controlpaths/tramuntana/hw/tramuntana_lite_r1a/img/tramuntana_asturcon_back.jpeg

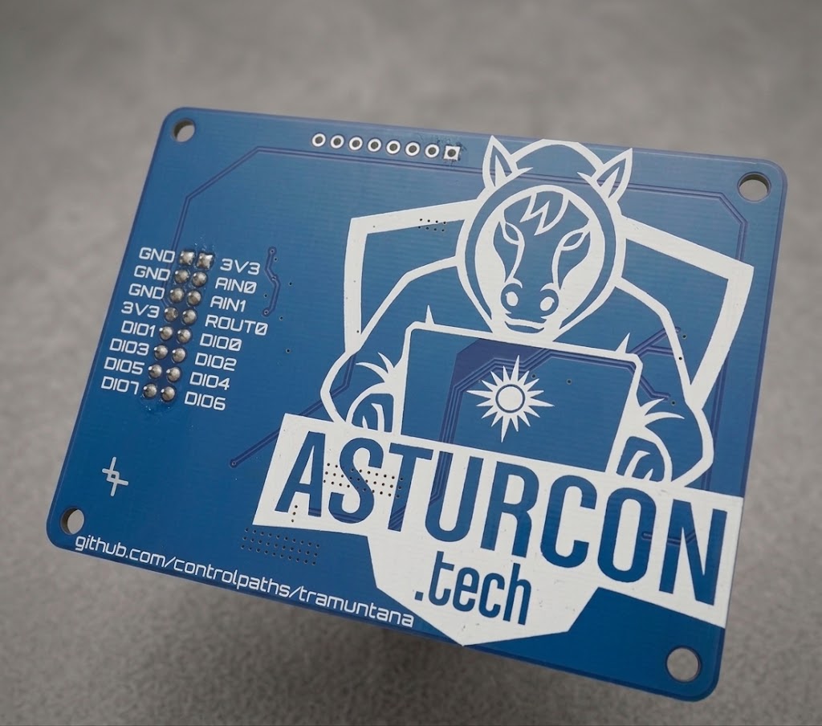
hw/tramuntana_lite_r1a/img/tramuntana_asturcon_back.jpeg
