controlpaths/tramuntana/hw/tramuntana_lite_r1a/case/tramuntana_lite_case_assembly.step

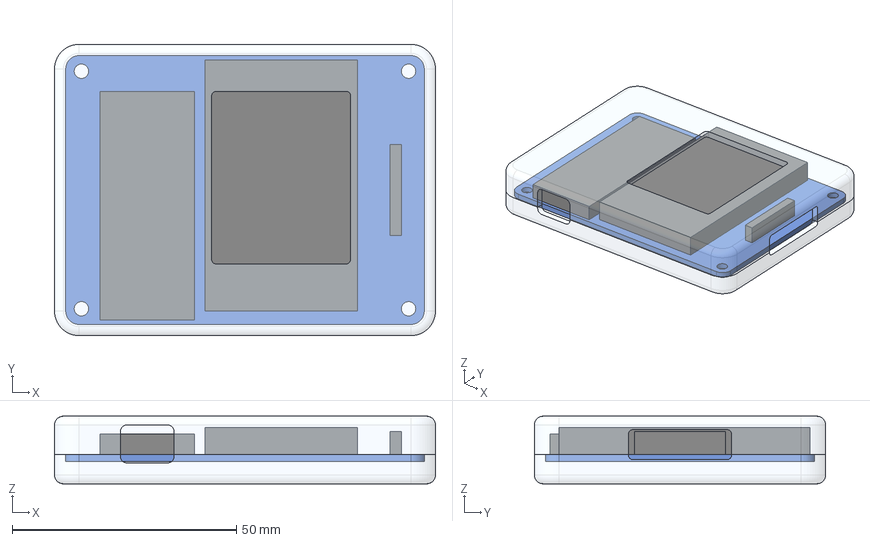
[picture p5: CAD file, 2026-10-11]
hw/tramuntana_lite_r1a/case/tramuntana_lite_case_assembly.step
85.0 x 65.0 x 15.1 mm
base
lid
pcb
display
pico
header
