controlpaths/tramuntana/hw/tramuntana_lite_r1a/case/tramuntana_lite_case_lid.step

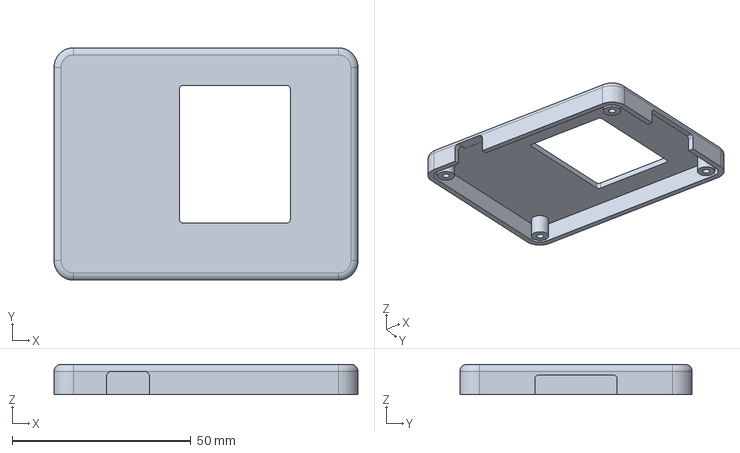
[picture p6: CAD file, 2026-10-11]
hw/tramuntana_lite_r1a/case/tramuntana_lite_case_lid.step
85.0 x 65.0 x 8.50 mm
