controlpaths/tramuntana/hw/tramuntana_lite_r1a/case/tramuntana_lite_case_lid_opaque_nodisplay.step

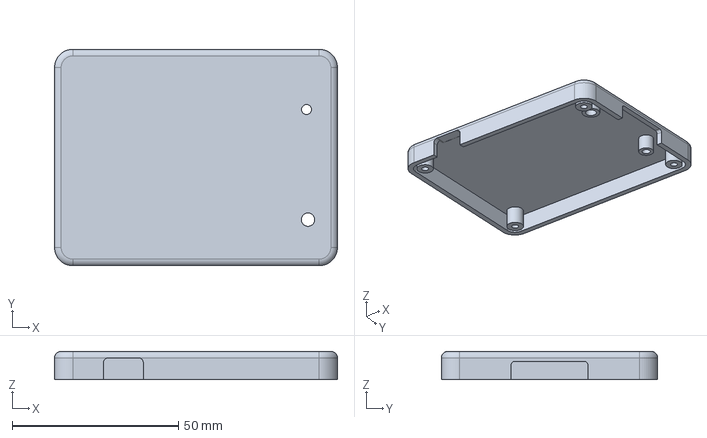
[picture p7: CAD file, 2026-10-11]
hw/tramuntana_lite_r1a/case/tramuntana_lite_case_lid_opaque_nodisplay.step
85.0 x 65.0 x 8.50 mm
