controlpaths/tramuntana/hw/tramuntana_lite_r1a/case/tramuntana_lite_case_base.step

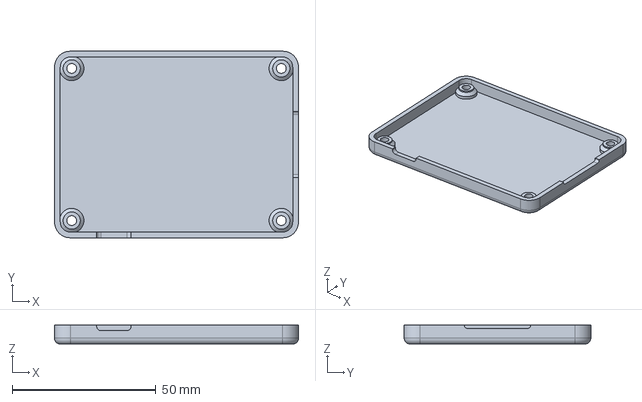
[picture p9: CAD file, 2026-10-11]
hw/tramuntana_lite_r1a/case/tramuntana_lite_case_base.step
85.0 x 65.0 x 6.60 mm
