controlpaths/tramuntana/(list of files, cad)

Other CAD files:
hw/tramuntana_lite_r1a/case/tramuntana_lite_case_base.stl
hw/tramuntana_lite_r1a/case/tramuntana_lite_case_lid.stl
hw/tramuntana_lite_r1a/case/tramuntana_lite_case_lid_nodisplay.stl
hw/tramuntana_lite_r1a/case/tramuntana_lite_case_lid_opaque.stl
hw/tramuntana_lite_r1a/case/tramuntana_lite_case_lid_opaque_nodisplay.stl
