controlpaths/tramuntana/hw/tramuntana_proto_r1a/kicad/tramuntana_proto_r1a.kicad_pcb

## KiCad design hw/tramuntana_proto_r1a/kicad/tramuntana_proto_r1a.kicad_pcb (2026-10-11)

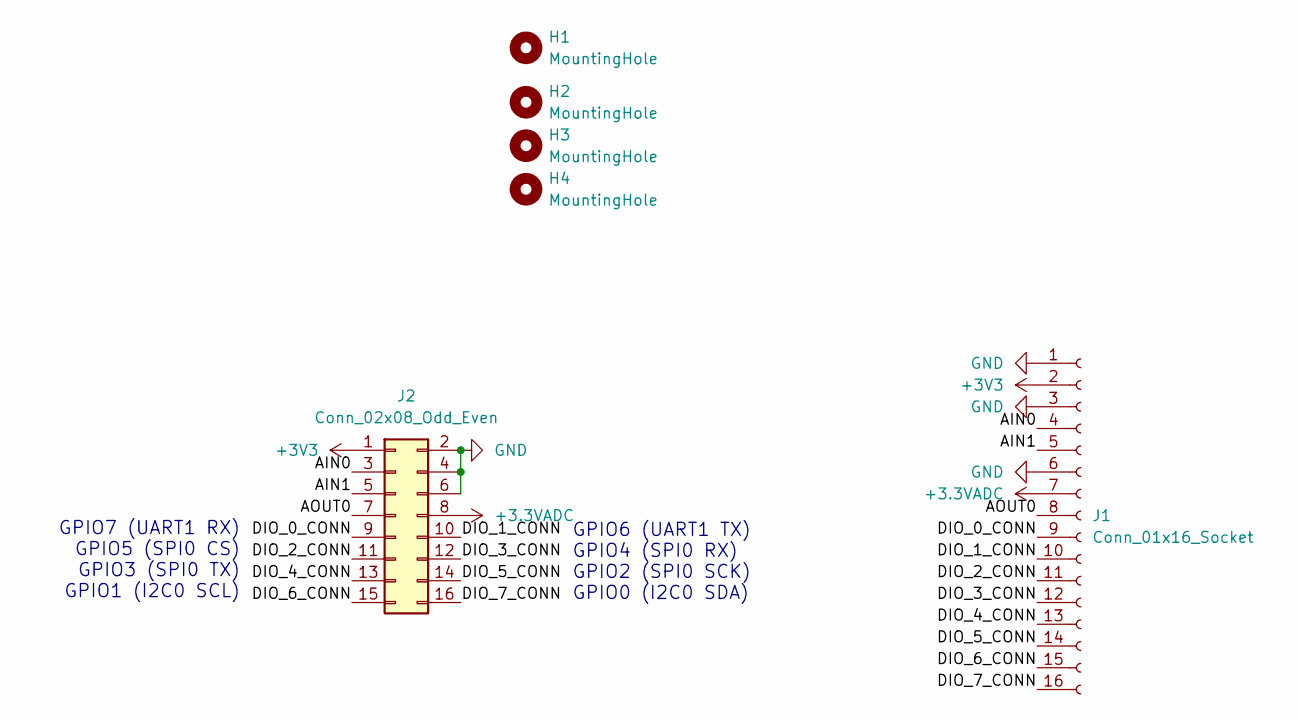
[picture p11: schematic tramuntana_proto_r1a.kicad_sch]

Parts:
H1, H2, H3, H4: MountingHole; MountingHole_3.2mm_M3
J1: Conn_01x16_Socket; PinSocket_1x16_P2.54mm_Vertical
J2: Conn_02x08_Odd_Even; PinSocket_2x08_P2.54mm_Horizontal

Connections:
+3.3VADC: J1.7, J2.8
+3V3: J1.2, J2.1
/AIN0: J1.4, J2.3
/AIN1: J1.5, J2.5
/AOUT0: J1.8, J2.7
/DIO_0_CONN: J1.9, J2.9
/DIO_1_CONN: J1.10, J2.10
/DIO_2_CONN: J1.11, J2.11
/DIO_3_CONN: J1.12, J2.12
/DIO_4_CONN: J1.13, J2.13
/DIO_5_CONN: J1.14, J2.14
/DIO_6_CONN: J1.15, J2.15
/DIO_7_CONN: J1.16, J2.16
GND: J1.1, J1.3, J1.6, J2.2, J2.4, J2.6

Notes on the sheet:
GPIO7 (UART1 RX) GPIO5 (SPI0 CS) GPIO3 (SPI0 TX) GPIO1 (I2C0 SCL)
GPIO6 (UART1 TX) GPIO4 (SPI0 RX) GPIO2 (SPI0 SCK) GPIO0 (I2C0 SDA)

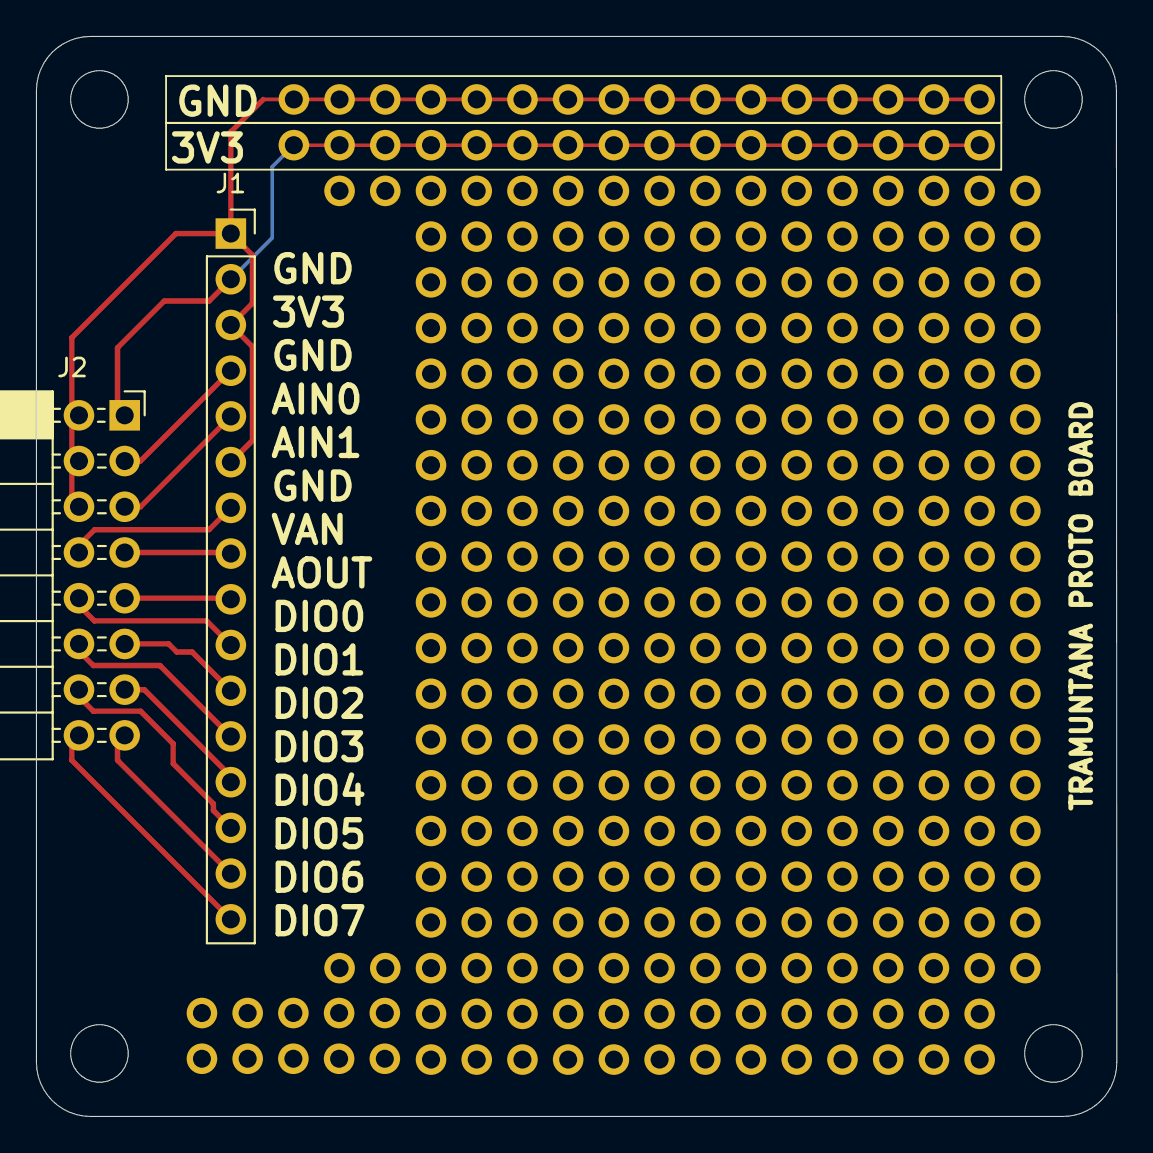
[picture p12: board tramuntana_proto_r1a.kicad_pcb from above]

Board: 2 copper layers, 60.0 x 60.0 mm, 6 parts (0 on the bottom side), 14 nets.
