controlpaths/tramuntana/hw/tramuntana_lite_r1a/kicad/tramuntana_lite_r1a.kicad_pcb

## KiCad design hw/tramuntana_lite_r1a/kicad/tramuntana_lite_r1a.kicad_pcb (2026-10-11)

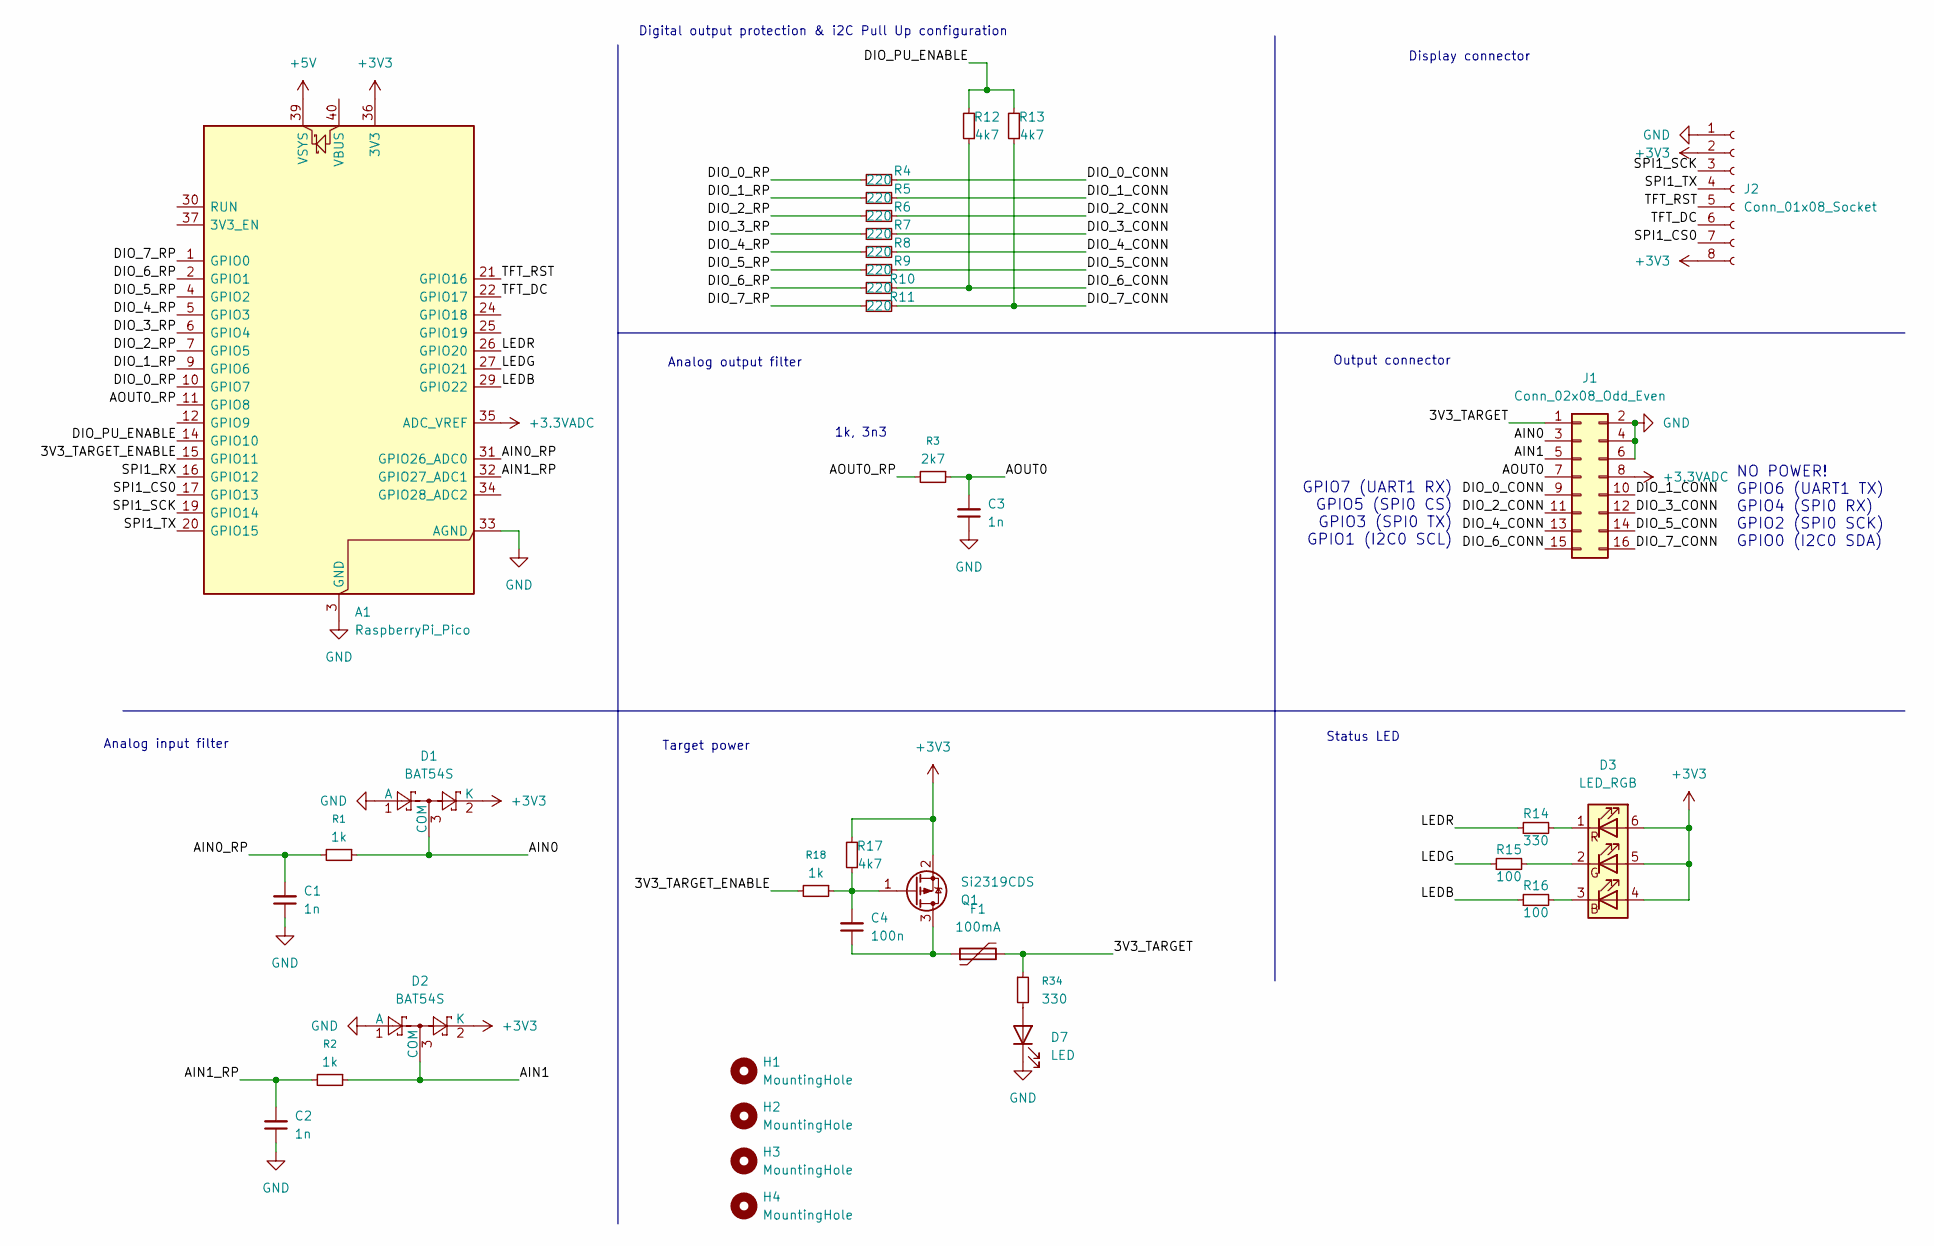
[picture p13: schematic tramuntana_lite_r1a.kicad_sch]

Parts:
A1: RaspberryPi_Pico; RaspberryPi_Pico_Common_Unspecified
C1, C2, C3: 1n; C_0603_1608Metric_Pad1.08x0.95mm_HandSolder
C4: 100n; C_0603_1608Metric_Pad1.08x0.95mm_HandSolder
D1, D2: BAT54S; SOT-23
D3: LED_RGB; LED_RGB_5050-6
D7: LED; LED_0603_1608Metric
F1: 100mA; Fuse_0805_2012Metric
H1, H2, H3, H4: MountingHole; MountingHole_3.2mm_M3
J1: Conn_02x08_Odd_Even; PinHeader_2x08_P2.54mm_Horizontal
J2: Conn_01x08_Socket; PinHeader_1x08_P2.54mm_Vertical
Q1: Si2319CDS; SOT-23
R1, R2: 1k; R_0603_1608Metric_Pad0.98x0.95mm_HandSolder
R3: 2k7; R_0603_1608Metric_Pad0.98x0.95mm_HandSolder
R4, R5, R6, R7, R8, R9, R10, R11: 220; R_0603_1608Metric
R12, R13, R17: 4k7; R_0603_1608Metric
R14: 330; R_0603_1608Metric
R15, R16: 100; R_0603_1608Metric
R18: 1k; R_0603_1608Metric
R34: 330; R_0603_1608Metric_Pad0.98x0.95mm_HandSolder

Connections:
+3.3VADC: A1.35 (ADC_VREF), J1.8
+3V3: A1.36 (3V3), D1.2 (K), D2.2 (K), D3.4 (BA), D3.5 (GA), D3.6 (RA), J2.2, J2.8, Q1.2 (S), R17.2
+5V: A1.39 (VSYS)
/3V3_TARGET: F1.2, J1.1, R34.1
/3V3_TARGET_ENABLE: A1.15 (GPIO11), R18.2
/AIN0: D1.3 (COM), J1.3, R1.1
/AIN0_RP: A1.31 (GPIO26_ADC0), C1.2, R1.2
/AIN1: D2.3 (COM), J1.5, R2.1
/AIN1_RP: A1.32 (GPIO27_ADC1), C2.2, R2.2
/AOUT0: C3.2, J1.7, R3.1
/AOUT0_RP: A1.11 (GPIO8), R3.2
/DIO_0_CONN: J1.9, R4.2
/DIO_0_RP: A1.10 (GPIO7), R4.1
/DIO_1_CONN: J1.10, R5.2
/DIO_1_RP: A1.9 (GPIO6), R5.1
/DIO_2_CONN: J1.11, R6.2
/DIO_2_RP: A1.7 (GPIO5), R6.1
/DIO_3_CONN: J1.12, R7.2
/DIO_3_RP: A1.6 (GPIO4), R7.1
/DIO_4_CONN: J1.13, R8.2
/DIO_4_RP: A1.5 (GPIO3), R8.1
/DIO_5_CONN: J1.14, R9.2
/DIO_5_RP: A1.4 (GPIO2), R9.1
/DIO_6_CONN: J1.15, R10.2, R12.1
/DIO_6_RP: A1.2 (GPIO1), R10.1
/DIO_7_CONN: J1.16, R11.2, R13.1
/DIO_7_RP: A1.1 (GPIO0), R11.1
/DIO_PU_ENABLE: A1.14 (GPIO10), R12.2, R13.2
/LEDB: A1.29 (GPIO22), R16.1
/LEDG: A1.27 (GPIO21), R15.1
/LEDR: A1.26 (GPIO20), R14.1
/SPI1_CS0: A1.17 (GPIO13), J2.7
/SPI1_RX: A1.16 (GPIO12)
/SPI1_SCK: A1.19 (GPIO14), J2.3
/SPI1_TX: A1.20 (GPIO15), J2.4
/TFT_DC: A1.22 (GPIO17), J2.6
/TFT_RST: A1.21 (GPIO16), J2.5
GND: A1.3 (GND), A1.8 (GND), A1.13 (GND), A1.18 (GND), A1.23 (GND), A1.28 (GND), A1.33 (AGND), A1.38 (GND), C1.1, C2.1, C3.1, D1.1 (A), D2.1 (A), D7.1 (K), J1.2, J1.4, J1.6, J2.1
unnamed: D3.3 (BK), R16.2
unnamed: D3.2 (GK), R15.2
unnamed: D3.1 (RK), R14.2
unnamed: D7.2 (A), R34.2
unnamed: C4.1, F1.1, Q1.3 (D)
unnamed: C4.2, Q1.1 (G), R17.1, R18.1

Notes on the sheet:
Target power
Output connector
Analog output filter
Analog input filter
NO POWER! GPIO6 (UART1 TX) GPIO4 (SPI0 RX) GPIO2 (SPI0 SCK) GPIO0 (I2C0 SDA)
Display connector
Status LED
Digital output protection & i2C Pull Up configuration
1k, 3n3
GPIO7 (UART1 RX) GPIO5 (SPI0 CS) GPIO3 (SPI0 TX) GPIO1 (I2C0 SCL)

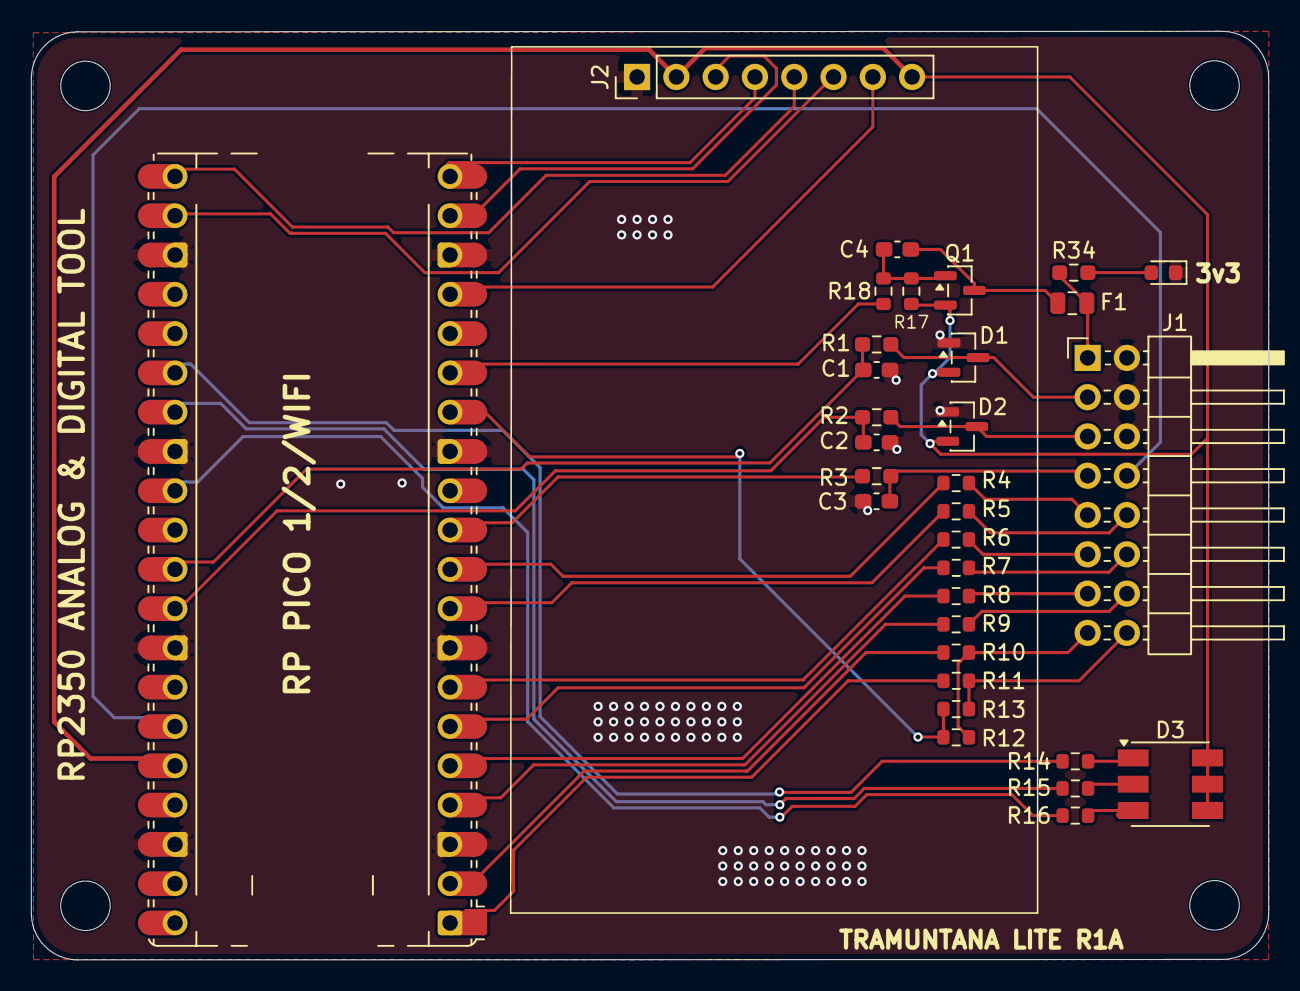
[picture p14: board tramuntana_lite_r1a.kicad_pcb from above]

Board: 2 copper layers, 80.0 x 60.0 mm, 36 parts (0 on the bottom side), 42 nets.
