controlpaths/tramuntana/host/python/tramuntana/mcp_server.py

"""MCP server exposing the Tramuntana hardware hacking tool to AI agents.

Lets an MCP client (Claude Code, Claude Desktop, Copilot...) drive a
Tramuntana board: target power, SPI/I2C master and sniffers, oscilloscope,
waveform generator, logic analyzer, DIO, ADC and the USB-UART bridge.

It is a thin layer over the rest of this package, so the agent does exactly
what the CLI, the webapp and user scripts do - nothing here talks the
binary protocol by itself.

Needs the [mcp] extra (pip install "tramuntana[mcp]"). Agents launch it over
stdio as `python -m tramuntana.mcp_server` (or the `tramuntana-mcp` script);
`tramuntana ai install <agent>` registers it.
"""

import functools
import io
import os
import threading
import time
from collections import deque
from typing import Annotated, Dict, List, Literal, Optional, Tuple

import serial

try:
    from pydantic import Field
    from mcp.server.fastmcp import FastMCP, Image
except ImportError as e:
    raise SystemExit(f"tramuntana MCP server: {e.name} is missing; install the extra with "
                     "pip install \"tramuntana[mcp]\"") from None

from tramuntana import (EmuTransfer, LinkError, ProtoError, Sequence, Timeline, Tramuntana, UartTap,
                        decode, find_ports)
from tramuntana import proto as P
from tramuntana.device import I2cMessage, SpiMessage, decode_event

INSTRUCTIONS = """\
Tramuntana is an RP2350-based bench tool for embedded targets, wired to the
target through a 16-pin header (J1):

  J1.1  3V3   switched 3.3 V rail for the target (tool: power)
  J1.3  AIN0  scope ch0 / adc 0      J1.5  AIN1  scope ch1 / adc 1   (0..3.3 V)
  J1.7  AOUT0 waveform generator (PWM + RC filter, 0..3.3 V)
  J1.9  DIO0  UART RX, logic ch0     J1.10 DIO1  UART TX, logic ch1
  J1.11 DIO2  SPI CS,   logic ch2    J1.12 DIO3  SPI MISO, logic ch3
  J1.13 DIO4  SPI MOSI, logic ch4    J1.14 DIO5  SPI SCK,  logic ch5
  J1.15 DIO6  I2C SCL,  logic ch6    J1.16 DIO7  I2C SDA,  logic ch7
  Every DIO is also a plain GPIO. UART: DIO1 -> target RX, DIO0 <- target TX.

Conventions: byte strings are hex ("9f 00 ff", "9f00ff" or "0x9f,0x00");
I2C addresses are 7-bit integers; voltages in volts; frequencies in Hz.
The connection is opened automatically on the first tool call; use
list_boards / connect only when several boards are plugged in.
Sniffers and the logic analyzer only listen, so they can watch traffic
generated by this same board (e.g. run logic_capture while doing I2C).
While the UART bridge port is open, DIO0/DIO1 belong to the UART and GPIO
use of them fails with 'busy'; SPI and I2C keep working alongside. Typical bring-up: power(on) -> i2c_scan /
spi_transaction to identify the target -> scope/logic to check signals.
Instruments that drive pins keep driving them after they are used: the SPI
master (CS/SCK/MOSI on DIO2..5), PWM outputs, the emulators. Release them
(spi_release, pwm_stop, emu_stop) before wiring a target that drives the same
pins; board_status shows who owns each DIO.
Captures are analysed on the host: scope results carry measurements (levels,
rise/fall time, frequency, duty, overshoot); logic captures can be decoded as
UART/I2C/SPI (decode= on logic_capture, or logic_decode to re-decode the last
capture with other pins/baud/mode without capturing again). scope_image and
logic_image return a PNG of the last capture to look at the waveform.

Debugging over time: timeline_start records, on one clock, the target's UART
output, sniffed I2C/SPI messages, edges on watched DIOs (reset, IRQ, LEDs),
transfers with an emulated device, sequencer runs and every action taken
through these tools; timeline_read shows a window of it, so cause and effect
line up ("the sensor NAKed 3 ms after reset, then the firmware printed
'not found'").
sequence_run executes a list of steps on the board itself with microsecond
timing (reset pulses, wait for a pin, bus transfers, delays, arming captures)
- use it whenever timing between steps matters; separate tool calls are
milliseconds to seconds apart.
emu_i2c / emu_spi make the board answer as a device on the target's bus,
from a 256-byte register file: test a firmware against a sensor returning any
value, or missing (emu_stop).
uart_ctrl maps the bridge port's RTS/DTR to two DIOs (reset/boot), so
esptool (and tools that reset a target the same way) can reset and flash it
through the bridge; uart_set_lines drives them from here.
"""

mcp = FastMCP("tramuntana", instructions=INSTRUCTIONS)

_lock = threading.RLock()
_dev: Optional[Tramuntana] = None
_want_port: Optional[str] = None
_want_serial: Optional[str] = None
_tap: Optional[UartTap] = None
_timeline: Optional[Timeline] = None
_emu_log: deque = deque(maxlen=200)
_last_scope = None      # last ScopeCapture downloaded, for scope_image
_last_logic = None      # last LogicCapture downloaded, for logic_decode / logic_image

LED_COLOURS = {
    "off": (0, 0, 0), "red": (1, 0, 0), "green": (0, 1, 0), "blue": (0, 0, 1),
    "yellow": (1, 1, 0), "cyan": (0, 1, 1), "magenta": (1, 0, 1), "white": (1, 1, 1),
}


# --- helpers -----------------------------------------------------------------------

# Tools that only look: not written to the timeline as actions.
QUIET_TOOLS = {
    "list_boards", "board_info", "board_status", "adc_read", "dio_read", "sniff_read", "scope_read",
    "logic_read", "logic_decode", "scope_image", "logic_image", "awg_status", "uart_read",
    "uart_status", "emu_status", "emu_get_registers", "timeline_read", "timeline_start", "pwm_status",
    "timeline_stop", "timeline_mark", "display_text", "display_pinout", "led",
}


def _describe(name: str, kwargs: dict) -> str:
    args = ", ".join(f"{k}={v!r}" for k, v in kwargs.items() if v is not None)
    text = f"{name}({args})"
    return text if len(text) <= 160 else text[:157] + "..."


def tool(fn):
    """@mcp.tool(), plus: every call of an acting tool is noted on the
    timeline while one is recording, so the agent's own actions show up
    next to their effects."""
    @functools.wraps(fn)
    def wrapper(*args, **kwargs):
        if _timeline is not None and _timeline.running and fn.__name__ not in QUIET_TOOLS:
            _timeline.note(_describe(fn.__name__, kwargs))
        return fn(*args, **kwargs)
    return mcp.tool()(wrapper)


def _on_event(cmd: int, payload: bytes):
    if cmd == P.EVT_EMU:
        _emu_log.append(decode_event(cmd, payload))


def _board() -> Tramuntana:
    """Returns the open board, connecting on first use."""
    global _dev
    if _dev is None:
        _dev = Tramuntana(port=_want_port, serial_number=_want_serial)
        _dev.link.add_listener(_on_event)
    return _dev


def _drop():
    global _dev
    if _timeline is not None and _timeline.running:
        try:
            _timeline.stop()       # entries stay readable; timeline_start again after reconnecting
        except Exception:
            pass
    if _dev is not None:
        try:
            _dev.close()
        except Exception:
            pass
    _dev = None


_I2C_MASTER_CMDS = {P.CMD_I2C_SCAN, P.CMD_I2C_WRITE, P.CMD_I2C_READ, P.CMD_I2C_WRITE_READ,
                    P.CMD_I2C_START, P.CMD_I2C_STOP, P.CMD_I2C_RAW_WRITE, P.CMD_I2C_RAW_READ,
                    P.CMD_I2C_RESET}


def _hint(t: Tramuntana, e: ProtoError) -> str:
    """What a bare status code means for the agent's next step."""
    if t is not None and e.status == 3 and e.cmd in _I2C_MASTER_CMDS:
        # The master released SCL and it never rose (10 ms clock-stretch limit).
        try:
            pullups = t.pullups()
        except Exception:
            pullups = None
        if pullups is False:
            return (" - SCL never went high. The board's I2C pull-ups are off: if the bus has no"
                    " pull-ups of its own, enable them with i2c_config(pullups=True) and retry.")
        return (" - SCL never went high although the pull-ups are on: something holds it low"
                " (a device stretching the clock for > 10 ms, a short, or an unpowered target"
                " clamping the line). Check the levels with dio_read and the target's power.")
    return ""


def _run(fn):
    """Runs fn(board) under the lock, turning library errors into readable ones.
    A link error drops the connection so the next call reconnects (replugged
    board, reflashed firmware...)."""
    with _lock:
        t = None
        try:
            t = _board()
            return fn(t)
        except ProtoError as e:
            raise RuntimeError(f"board rejected the command: {e}{_hint(t, e)}") from None
        except (LinkError, serial.SerialException, OSError) as e:
            _drop()
            raise RuntimeError(f"link error: {e}") from None


def _hex_in(s: str) -> bytes:
    """Parses '9f 00 ff', '9f00ff', '0x9f,0x00', '9f:00' into bytes."""
    out = bytearray()
    for tok in s.replace(",", " ").replace(":", " ").split():
        tok = tok.lower().removeprefix("0x")
        if len(tok) % 2:
            tok = "0" + tok
        out += bytes.fromhex(tok)
    return bytes(out)


def _hex_out(b: bytes) -> str:
    return b.hex(" ")


def _abspath(path: Optional[str]) -> Optional[str]:
    return os.path.abspath(os.path.expanduser(path)) if path else None


def _decimate(values: List[float], max_points: int) -> Tuple[List[float], int]:
    step = max(1, -(-len(values) // max_points))
    return values[::step], step


# --- board -------------------------------------------------------------------------

@tool
def list_boards() -> List[dict]:
    """List the Tramuntana boards plugged in (USB serial number and the
    shell / api / uart device paths of each)."""
    return find_ports()


@tool
def connect(
    port: Annotated[Optional[str], Field(description="API port, e.g. /dev/ttyACM1. Omit to autodetect.")] = None,
    serial_number: Annotated[Optional[str], Field(description="USB serial number of the board to use (see list_boards).")] = None,
) -> dict:
    """(Re)connect to a Tramuntana board and return its info. Only needed to
    pick a specific board: every other tool connects automatically."""
    global _want_port, _want_serial
    with _lock:
        _drop()
        _want_port, _want_serial = port, serial_number
        return _run(lambda t: {"port": t.port, **t.info()})


@tool
def disconnect() -> str:
    """Close the API connection (and the UART bridge port, if open)."""
    with _lock:
        _drop()
        _uart_close()
    return "disconnected"


@tool
def board_info() -> dict:
    """Firmware version, board name, system clock, chip id and protocol version."""
    return _run(lambda t: {"port": t.port, **t.info()})


@tool
def board_status() -> dict:
    """Owner of each DIO pin (gpio/spi/i2c/uart/pio, '!' = held exclusively),
    target power, pull-ups, state of every instrument and API bytes dropped."""
    def f(t):
        st = t.status()
        st["pins"] = {f"DIO{i}": o for i, o in enumerate(st["pins"])}
        return st
    return _run(f)


@tool
def power(
    on: Annotated[Optional[bool], Field(description="True = rail on, False = off, omit = just read.")] = None,
) -> dict:
    """Switch (or read) the protected 3.3 V rail that powers the target (J1.1)."""
    return _run(lambda t: {"power": t.power(on)})


@tool
def pullups(
    on: Annotated[Optional[bool], Field(description="True = on, False = off, omit = just read.")] = None,
) -> dict:
    """Switch (or read) the board's I2C pull-ups on DIO6/DIO7. Turn them on
    when the target has no pull-ups of its own."""
    return _run(lambda t: {"pullups": t.pullups(on)})


@tool
def led(
    colour: Annotated[Literal["off", "red", "green", "blue", "yellow", "cyan", "magenta", "white", "auto"],
                      Field(description="'auto' gives the LED back to the firmware.")],
) -> str:
    """Set the board's RGB status LED."""
    def f(t):
        if colour == "auto":
            t.led(None)
        else:
            r, g, b = LED_COLOURS[colour]
            t.led(bool(r), bool(g), bool(b))
        return f"led {colour}"
    return _run(f)


@tool
def display_text(
    text: Annotated[str, Field(max_length=24, description="Up to 24 ASCII characters.")],
) -> str:
    """Show a short label on the board's screen (e.g. what the agent is doing)."""
    return _run(lambda t: (t.display(text), "ok")[1])


@tool
def display_pinout(
    seconds: Annotated[Optional[int], Field(ge=0, le=65534, description=(
        "How long the board shows it; 0 = back to the dashboard now, omit = until called again."))] = 60,
) -> dict:
    """Draw the J1 header on the board's own screen (every pin's name and
    function), so the user can see where each wire goes while wiring a
    target. Returns the same pin table for the conversation."""
    from tramuntana.pinout import PINS
    _run(lambda t: t.display_pinout(seconds))
    return {"shown_on_board": seconds != 0,
            "pins": [{"pin": p.number, "name": p.name, "function": p.function} for p in PINS]}


@tool
def adc_read(
    channel: Annotated[Literal[0, 1], Field(description="0 = AIN0 (J1.3), 1 = AIN1 (J1.5).")] = 0,
) -> dict:
    """One voltage reading of AIN0 or AIN1 (0..3.3 V), a quick voltmeter."""
    return _run(lambda t: {"channel": channel, "volts": t.adc(channel)})


@tool
def dio_read() -> dict:
    """Read the levels of DIO7..DIO0 (works whoever owns the pins)."""
    def f(t):
        v = t.dio_read()
        return {"value": f"0x{v:02x}", "pins": {f"DIO{i}": (v >> i) & 1 for i in range(8)}}
    return _run(f)


@tool
def dio_set_direction(
    mask: Annotated[int, Field(ge=0, le=255, description="Pins to configure (bit i = DIOi).")],
    out_mask: Annotated[int, Field(ge=0, le=255, description="Of those, which become outputs (1) or inputs (0).")],
) -> str:
    """Set DIO pins as plain GPIO inputs or outputs."""
    return _run(lambda t: (t.dio_dir(mask, out_mask), "ok")[1])


@tool
def dio_write(
    mask: Annotated[int, Field(ge=0, le=255, description="Pins to drive (bit i = DIOi); must be outputs.")],
    value: Annotated[int, Field(ge=0, le=255, description="Levels for the pins in mask.")],
) -> str:
    """Drive DIO output pins (configure them with dio_set_direction first)."""
    return _run(lambda t: (t.dio_write(mask, value), "ok")[1])


@tool
def bootloader() -> str:
    """Reboot the Tramuntana into its UF2 bootloader (the RP2350 drive appears
    and the connection is lost). Only use it when asked to update firmware."""
    with _lock:
        _run(lambda t: t.bootloader())
        _drop()
    return "rebooting into the UF2 bootloader"


# --- SPI ---------------------------------------------------------------------------

@tool
def spi_config(
    freq_hz: Annotated[int, Field(gt=0, le=75_000_000, description="SCK frequency.")] = 1_000_000,
    mode: Annotated[Literal[0, 1, 2, 3], Field(description="SPI mode (CPOL/CPHA).")] = 0,
    lsb_first: bool = False,
) -> dict:
    """Configure the SPI master (DIO2 CS, DIO3 MISO, DIO4 MOSI, DIO5 SCK).
    Returns the actual clock frequency."""
    return _run(lambda t: {"freq_hz": t.spi.config(freq_hz, mode, lsb_first), "mode": mode,
                           "lsb_first": lsb_first})


@tool
def spi_transaction(
    write: Annotated[str, Field(description="Hex bytes to send first, e.g. '9f' or '03 00 00 00'.")],
    read_n: Annotated[int, Field(ge=0, le=4096, description="Bytes to read after the write.")] = 0,
    release: Annotated[bool, Field(description=(
        "Release DIO2..5 afterwards (see spi_release) instead of leaving CS high and "
        "SCK/MOSI driven."))] = False,
) -> dict:
    """One complete SPI transaction: CS low, write bytes, read read_n bytes
    (clocking 0x00), CS high. E.g. write='9f', read_n=3 reads a flash JEDEC id.
    The first SCK edge comes ~50 us after CS goes low, and SCK stops for
    ~100 us between the write and the read phase (CS stays low)."""
    def f(t):
        rx = t.spi.txn(_hex_in(write), read_n)
        if release:
            t.spi.release()
        return {"read": _hex_out(rx)}
    return _run(f)


@tool
def spi_xfer(
    data: Annotated[str, Field(description="Hex bytes to shift out.")],
    manage_cs: Annotated[bool, Field(description="True: assert CS before and release it after. "
                                                 "False: leave CS as it is (see spi_select).")] = True,
) -> dict:
    """Full-duplex SPI transfer: returns the bytes clocked in on MISO while
    'data' is shifted out on MOSI."""
    def f(t):
        if manage_cs:
            t.spi.sel()
        try:
            rx = t.spi.xfer(_hex_in(data))
        finally:
            if manage_cs:
                t.spi.unsel()
        return {"miso": _hex_out(rx)}
    return _run(f)


@tool
def spi_select(
    active: Annotated[bool, Field(description="True = CS low (selected), False = CS high.")],
) -> str:
    """Drive the SPI chip select by hand, to build multi-step transactions
    with spi_write / spi_read / spi_xfer(manage_cs=False)."""
    return _run(lambda t: (t.spi.sel() if active else t.spi.unsel(), "CS low" if active else "CS high")[1])


@tool
def spi_write(data: Annotated[str, Field(description="Hex bytes to send.")]) -> str:
    """Send bytes on MOSI without touching CS (MISO is ignored)."""
    return _run(lambda t: (t.spi.write(_hex_in(data)), "ok")[1])


@tool
def spi_release() -> str:
    """Stop driving the SPI master's pins (DIO2..5 back to plain inputs).
    After any SPI tool CS, SCK and MOSI stay driven; release them before
    connecting something that drives DIO2..5, or before using those pins
    to watch a signal. The next SPI tool call takes them again."""
    return _run(lambda t: (t.spi.release(), "DIO2..5 released")[1])


@tool
def spi_read(
    n: Annotated[int, Field(ge=1, le=65536, description="Bytes to read.")],
    fill: Annotated[int, Field(ge=0, le=255, description="Byte sent on MOSI while reading.")] = 0,
) -> dict:
    """Read bytes from MISO without touching CS."""
    return _run(lambda t: {"read": _hex_out(t.spi.read(n, fill))})


# --- I2C ---------------------------------------------------------------------------

@tool
def i2c_config(
    freq_hz: Annotated[int, Field(ge=1000, le=1_000_000, description="SCL frequency.")] = 100_000,
    pullups: Annotated[bool, Field(description="Enable the board's pull-ups on SDA/SCL.")] = True,
) -> dict:
    """Configure the I2C master (DIO6 SCL, DIO7 SDA). Returns the actual frequency."""
    return _run(lambda t: {"freq_hz": t.i2c.config(freq_hz, pullups), "pullups": pullups})


@tool
def i2c_scan() -> dict:
    """Scan the I2C bus and list the 7-bit addresses that ACK."""
    def f(t):
        found = t.i2c.scan()
        return {"addresses": [f"0x{a:02x}" for a in found], "count": len(found)}
    return _run(f)


@tool
def i2c_write(
    address: Annotated[int, Field(ge=0, le=127, description="7-bit address.")],
    data: Annotated[str, Field(description="Hex bytes, e.g. '6b 00' (register, value).")],
) -> dict:
    """START, address+W, bytes, STOP. Fails on NAK."""
    return _run(lambda t: {"acked": t.i2c.write(address, _hex_in(data))})


@tool
def i2c_read(
    address: Annotated[int, Field(ge=0, le=127, description="7-bit address.")],
    n: Annotated[int, Field(ge=1, le=4096, description="Bytes to read.")],
) -> dict:
    """START, address+R, read n bytes, STOP."""
    return _run(lambda t: {"read": _hex_out(t.i2c.read(address, n))})


@tool
def i2c_write_read(
    address: Annotated[int, Field(ge=0, le=127, description="7-bit address.")],
    write: Annotated[str, Field(description="Hex bytes to write first, usually the register address.")],
    n: Annotated[int, Field(ge=1, le=4096, description="Bytes to read after the repeated START.")],
) -> dict:
    """Register read: write bytes, repeated START, read n bytes, STOP.
    E.g. address=0x68, write='75', n=1 reads WHO_AM_I of an MPU-6050."""
    return _run(lambda t: {"read": _hex_out(t.i2c.write_read(address, _hex_in(write), n))})


@tool
def i2c_sequence(
    steps: Annotated[List[Dict], Field(description=(
        "Ordered steps. Each is one of: "
        "{'op':'start','address':0x50,'read':false} (START or repeated START + address), "
        "{'op':'write','data':'00 10'}, "
        "{'op':'read','n':4,'nack_last':true}, "
        "{'op':'stop'}."))],
) -> List[dict]:
    """Low-level I2C (I2CDriver style) for sequences a datasheet asks for that
    i2c_write / i2c_write_read can't express. Returns the result of each step;
    a STOP is sent if a step fails with the bus still open."""
    def f(t):
        out = []
        open_bus = False
        try:
            for s in steps:
                op = s.get("op")
                if op == "start":
                    ack = t.i2c.start(int(s["address"]), bool(s.get("read", False)))
                    open_bus = True
                    out.append({"op": "start", "ack": ack})
                elif op == "write":
                    out.append({"op": "write", "acked": t.i2c.raw_write(_hex_in(s["data"]))})
                elif op == "read":
                    rx = t.i2c.raw_read(int(s["n"]), bool(s.get("nack_last", True)))
                    out.append({"op": "read", "data": _hex_out(rx)})
                elif op == "stop":
                    t.i2c.stop()
                    open_bus = False
                    out.append({"op": "stop"})
                else:
                    raise ValueError(f"unknown step {s!r}")
        except Exception:
            if open_bus:
                try:
                    t.i2c.stop()
                except Exception:
                    pass
            raise
        return out
    return _run(f)


@tool
def i2c_bus_reset() -> str:
    """Clock SCL until a stuck slave releases SDA, then send a STOP."""
    return _run(lambda t: (t.i2c.reset_bus(), "bus reset")[1])


# --- sniffers ----------------------------------------------------------------------

@tool
def sniff_start(
    bus: Literal["spi", "i2c"],
    spi_mode: Annotated[Optional[Literal[0, 1, 2, 3]], Field(description="SPI mode of the sniffed bus.")] = None,
    i2c_pullups: Annotated[bool, Field(description="Enable the board's pull-ups while sniffing I2C.")] = False,
) -> str:
    """Start the passive SPI (DIO2..5) or I2C (DIO6/7) sniffer. It only
    listens, so it can watch a target's own master or this board's. Collect
    messages with sniff_read and stop with sniff_stop."""
    def f(t):
        t.link.events.clear()
        if bus == "spi":
            t.spi.sniff(True, spi_mode)
        else:
            t.i2c.sniff(True, i2c_pullups)
        return f"{bus} sniffer on"
    return _run(f)


@tool
def sniff_read(
    duration_s: Annotated[float, Field(ge=0, le=60, description="How long to wait for messages.")] = 1.0,
    max_messages: Annotated[int, Field(ge=1, le=1000, description=(
        "At most this many per call (1000 max); the rest stay queued ('pending').")) ] = 100,
) -> dict:
    """Return the sniffed messages captured so far, waiting up to duration_s
    for more. SPI: MOSI/MISO bytes (first 256 of each message). I2C: frames
    as 'S 50W+ 00+ 10+ P' (+ = ACK, - = NAK). One call returns at most
    max_messages (<= 1000) and stops early when it has them, so to count a
    rate over a long window call it repeatedly until 'pending' is 0, or
    compare counts over the same number of calls."""
    def f(t):
        msgs = []
        deadline = time.monotonic() + duration_s
        while len(msgs) < max_messages:
            while t.link.events and len(msgs) < max_messages:
                for ev in t.events(timeout=0):
                    if isinstance(ev, SpiMessage):
                        msgs.append({"bus": "spi", "total": ev.total, "mosi": _hex_out(ev.mosi),
                                     "miso": _hex_out(ev.miso), "overrun": ev.overrun})
                    elif isinstance(ev, I2cMessage):
                        msgs.append({"bus": "i2c", "text": str(ev)[4:], "overrun": ev.overrun,
                                     "truncated": ev.truncated})
                    if len(msgs) >= max_messages:
                        break
            if time.monotonic() >= deadline:
                break
            time.sleep(0.02)
        return {"messages": msgs, "count": len(msgs), "pending": len(t.link.events)}
    return _run(f)


@tool
def sniff_stop(bus: Literal["spi", "i2c", "both"] = "both") -> str:
    """Stop the SPI and/or I2C sniffer."""
    def f(t):
        if bus in ("spi", "both"):
            t.spi.sniff(False)
        if bus in ("i2c", "both"):
            t.i2c.sniff(False)
        return f"{bus} sniffer off"
    return _run(f)


# --- scope -------------------------------------------------------------------------

NO_CAPTURE_HINT = {
    "armed": "still waiting for the trigger: call the *_read tool again, or it times out",
    "running": "still capturing: call the *_read tool again",
    "timeout": "the trigger condition never happened within timeout_ms",
    "aborted": "the capture was aborted",
    "idle": "nothing armed",
}


def _wait_capture(inst, wait_s: float) -> dict:
    """Waits for a capture to leave armed/running. A missing trigger is a
    result for the agent, not an error, so this never raises for it."""
    try:
        return inst.wait(timeout=wait_s)
    except LinkError:
        return inst.status()      # still armed/running after wait_s


def _not_done(st: dict) -> dict:
    return {"state": st["state"], "captured": False, "hint": NO_CAPTURE_HINT.get(st["state"], "")}


def _round(d: dict) -> dict:
    return {k: (float(f"{v:.4g}") if isinstance(v, float) else v) for k, v in d.items()}


def _scope_summary(t, wait_s: float, max_points: int, csv_path: Optional[str]) -> dict:
    global _last_scope
    st = _wait_capture(t.scope, wait_s)
    if st["state"] != "done":
        return _not_done(st)
    cap = _last_scope = t.scope.read()
    out = {"state": "done", "captured": True, "rate_hz": cap.rate_hz, "n": cap.n,
           "trigger_index": cap.trigger_index, "duration_s": cap.n / cap.rate_hz, "channels": {}}
    for ch in range(cap.channels):
        st = {k: (round(v, 4) if isinstance(v, float) else v) for k, v in cap.stats(ch).items()}
        entry = {"stats": st, "measure": _round(decode.measure(cap, ch))}
        if max_points:
            pts, step = _decimate([round(v, 3) for v in cap.volts(ch)], max_points)
            entry.update({"volts": pts, "point_spacing_s": step / cap.rate_hz})
        out["channels"][f"AIN{ch}"] = entry
    if max_points:
        out["t0_s"] = -cap.trigger_index / cap.rate_hz
    if csv_path:
        cap.to_csv(_abspath(csv_path))
        out["csv"] = _abspath(csv_path)
    return out


MaxPoints = Annotated[int, Field(ge=0, le=4096, description=(
    "Waveform points returned per channel (decimated); 0 = only statistics."))]
ScopeCsv = Annotated[Optional[str], Field(description="Also save the full capture as CSV here.")]


@tool
def scope_capture(
    n: Annotated[int, Field(ge=16, le=16384, description="Samples per channel (n*channels <= 16384).")] = 1024,
    channels: Annotated[Literal[1, 2], Field(description="1 = AIN0, 2 = AIN0 + AIN1.")] = 1,
    rate_hz: Annotated[Optional[float], Field(gt=0, le=500_000, description=(
        "Sample rate per channel; the aggregate is limited to 500 kS/s. Omit for the maximum."))] = None,
    trigger: Literal["none", "rising", "falling"] = "none",
    level_v: Annotated[float, Field(ge=0, le=3.3, description="Trigger level on AIN0.")] = 1.65,
    pre: Annotated[int, Field(ge=0, description="Samples kept before the trigger.")] = 0,
    timeout_ms: Annotated[int, Field(ge=1, le=60000, description="Give up if no trigger.")] = 5000,
    wait: Annotated[bool, Field(description=(
        "True: wait and return the capture. False: only arm and return at once, so other tools "
        "can stimulate the target (awg_step, dio_write...) before scope_read."))] = True,
    max_points: MaxPoints = 128,
    csv_path: ScopeCsv = None,
) -> dict:
    """Capture AIN0 (and AIN1) with the 12-bit scope, optionally triggered on
    AIN0 with pre-trigger. Returns per-channel stats (min/max/vpp/mean/rms and
    a frequency estimate), measurements (low/high levels, 10-90 % rise and
    fall time, period, duty, overshoot) and a decimated waveform in volts.
    scope_image draws it. If the trigger never comes the result has
    captured=false and state='timeout'."""
    if n * channels > 16384:
        raise ValueError("n * channels must be <= 16384")

    def f(t):
        rate = t.scope.arm(n=n, channels=channels, rate_hz=rate_hz, trigger=trigger,
                           level=level_v, pre=pre, timeout_ms=timeout_ms)
        if not wait:
            return {"state": "armed", "rate_hz": rate, "next": "call scope_read"}
        return _scope_summary(t, timeout_ms / 1000 + 5, max_points, csv_path)
    return _run(f)


@tool
def scope_read(
    wait_s: Annotated[float, Field(ge=0, le=60, description="How long to wait for the capture to finish.")] = 5.0,
    max_points: MaxPoints = 128,
    csv_path: ScopeCsv = None,
) -> dict:
    """Result of a capture armed with scope_capture(wait=false)."""
    return _run(lambda t: _scope_summary(t, wait_s, max_points, csv_path))


# --- waveform generator ------------------------------------------------------------

@tool
def awg_set(
    shape: Literal["sine", "tri", "saw", "square", "stairs"],
    freq_hz: Annotated[float, Field(ge=1, le=100_000)],
    amp_v: Annotated[float, Field(ge=0, le=1.65, description="Peak amplitude.")] = 1.0,
    offset_v: Annotated[float, Field(ge=0, le=3.3, description="Centre voltage.")] = 1.65,
    param: Annotated[int, Field(ge=0, le=65535, description="Duty % for square, number of steps for stairs.")] = 0,
) -> dict:
    """Start the waveform generator on AOUT0 (J1.7). Output range is 0..3.3 V,
    so keep offset +- amp inside it. Keeps running until awg_off."""
    if shape == "square" and param == 0:
        param = 50
    return _run(lambda t: t.awg.set(shape, freq_hz, amp_v, offset_v, param))


@tool
def awg_arbitrary(
    samples: Annotated[List[float], Field(min_length=2, max_length=4096,
                                          description="One period, values in -1..1.")],
    freq_hz: Annotated[float, Field(ge=1, le=100_000, description="Periods per second.")],
    amp_v: Annotated[float, Field(ge=0, le=1.65)] = 1.65,
    offset_v: Annotated[float, Field(ge=0, le=3.3)] = 1.65,
) -> dict:
    """Play an arbitrary waveform (one period of up to 4096 points) on AOUT0."""
    return _run(lambda t: t.awg.arbitrary(samples, freq_hz, amp_v, offset_v))


@tool
def awg_dc(volts: Annotated[float, Field(ge=0, le=3.3)]) -> str:
    """Output a DC level on AOUT0."""
    return _run(lambda t: (t.awg.dc(volts), f"AOUT0 = {volts} V")[1])


@tool
def awg_step(
    from_v: Annotated[float, Field(ge=0, le=3.3)],
    to_v: Annotated[float, Field(ge=0, le=3.3)],
    delay_ms: Annotated[int, Field(ge=0, le=65535, description="Time at from_v before stepping.")],
) -> str:
    """Output from_v, then step to to_v after delay_ms (step-response tests;
    pair it with scope_capture triggered on the edge)."""
    return _run(lambda t: (t.awg.step(from_v, to_v, delay_ms), "step armed")[1])


@tool
def awg_off() -> str:
    """Stop the waveform generator."""
    return _run(lambda t: (t.awg.off(), "awg off")[1])


@tool
def awg_status() -> dict:
    """Current waveform generator state."""
    return _run(lambda t: t.awg.status())


# --- PWM outputs -------------------------------------------------------------------

PwmDio = Annotated[int, Field(ge=0, le=7, description=(
    "DIO to drive. Pairs share a frequency and phase: DIO7/6, DIO5/4, DIO3/2, DIO1/0."))]


@tool
def pwm_set(
    dio: PwmDio,
    freq_hz: Annotated[float, Field(ge=10, le=75e6, description="Frequency (integer dividers of 150 MHz are exact).")],
    duty: Annotated[float, Field(ge=0, le=100, description="Duty cycle in %.")] = 50.0,
    invert: bool = False,
) -> dict:
    """Start (or update) a hardware PWM on one DIO: a clock, a BCLK/LRCLK
    pair, a test pattern for the target. Duty/polarity changes are
    glitch-free. Fails with 'busy' if the pair partner already runs at
    another frequency. The output keeps running until pwm_stop."""
    return _run(lambda t: {"dio": dio, **t.pwm.set(dio, freq_hz, duty, invert)})


@tool
def pwm_phase(
    dio: PwmDio,
    degrees: Annotated[int, Field(ge=0, le=359, description="Delay of the pair, in degrees of its period.")],
) -> str:
    """Phase delay of the pair 'dio' belongs to; takes effect on pwm_sync."""
    return _run(lambda t: (t.pwm.phase(dio, degrees), f"pair of DIO{dio}: {degrees} deg on next sync")[1])


@tool
def pwm_sync(
    dio_mask: Annotated[int, Field(ge=0, le=255, description="Pairs to restart (bit i = DIOi); 0 = every live pair.")] = 0,
) -> str:
    """Restart PWM pairs on the same clock edge, each delayed by its phase:
    pairs at the same or integer-ratio frequencies then stay phase-locked
    (e.g. I2S BCLK and LRCLK = BCLK/64)."""
    return _run(lambda t: (t.pwm.sync(dio_mask), "synced")[1])


@tool
def pwm_stop(
    dio_mask: Annotated[int, Field(ge=0, le=255, description="DIOs to stop (bit i = DIOi).")] = 0xFF,
) -> str:
    """Stop PWM outputs and give the pins back as plain inputs."""
    return _run(lambda t: (t.pwm.stop(dio_mask), "stopped")[1])


@tool
def pwm_status() -> dict:
    """Every DIO's PWM: active, requested and actual frequency, duty, phase,
    and 'lost' if another instrument took the pin over."""
    return _run(lambda t: {f"DIO{i}": st for i, st in enumerate(t.pwm.status()) if st["active"] or st["lost"]})


# --- logic analyzer ----------------------------------------------------------------

def _logic_channel(cap, dio: int, max_edges: int) -> dict:
    bits = cap.channel(dio)
    edges = cap.edges(dio)
    rising = [i for i, lvl in edges if lvl == 1]
    out = {"initial": bits[0] if bits else None, "final": bits[-1] if bits else None,
           "edges": len(edges), "high_fraction": round(sum(bits) / len(bits), 4) if bits else None}
    if len(rising) >= 2:
        out["freq_hz"] = round(cap.rate_hz * (len(rising) - 1) / (rising[-1] - rising[0]), 3)
    if max_edges and edges:
        us = 1e6 / cap.rate_hz
        out["first_edges"] = [{"t_us": round((i - cap.trigger_index) * us, 4),
                               "level": lvl} for i, lvl in edges[:max_edges]]
    return out


def _unexpected_nak(f) -> bool:
    """A NAK on the address or on a written byte; the master NAKs the last
    byte of a read on purpose."""
    data = f.data[:-1] if f.read else f.data
    return f.ack is False or any(not a for _, a in data)


def _decode(cap, protocol: str, max_items: int, pin: Optional[int] = None, baud: Optional[int] = None,
            parity: str = "none", stop_bits: int = 1, scl: int = 6, sda: int = 7,
            cs: Optional[int] = 2, sck: int = 5, mosi: Optional[int] = 4, miso: Optional[int] = 3,
            spi_mode: int = 0, lsb_first: bool = False) -> dict:
    """Decodes a logic capture; defaults follow the J1 pinout."""
    if protocol == "uart":
        pin = 0 if pin is None else pin
        guessed = baud is None
        if guessed:
            baud = decode.guess_baud(cap, pin)
            if baud is None:
                return {"protocol": "uart", "pin": pin, "error": f"too few edges on DIO{pin} to guess the baud rate"}
        frames = decode.uart(cap, pin, baud, parity=parity, stop_bits=stop_bits)
        out = {"protocol": "uart", "pin": pin, "baud": baud, "baud_guessed": guessed,
               "count": len(frames), "text": decode.uart_text(frames[:max_items]),
               "parity_errors": sum(f.parity_error for f in frames),
               "framing_errors": sum(f.framing_error for f in frames)}
        if out["framing_errors"]:
            out["hint"] = "framing errors usually mean a wrong baud rate or framing, or a break"
        if frames:
            out["first_s"], out["last_s"] = frames[0].t_s, frames[-1].t_s
        return out
    if protocol == "i2c":
        tr = decode.i2c(cap, scl, sda)
        return {"protocol": "i2c", "scl": scl, "sda": sda, "count": len(tr),
                "with_nak": sum(any(_unexpected_nak(f) for f in x.message.frames) for x in tr),
                "transfers": [{"t_us": round(x.t_s * 1e6, 3), "text": str(x).split("us ", 1)[1],
                               "scl_hz": x.scl_hz, "bit_rate_hz": x.bit_rate_hz} for x in tr[:max_items]]}
    tr = decode.spi(cap, cs, sck, mosi, miso, spi_mode, lsb_first)
    return {"protocol": "spi", "cs": cs, "sck": sck, "mosi": mosi, "miso": miso, "mode": spi_mode,
            "count": len(tr),
            "transfers": [{"t_us": round(x.t_s * 1e6, 3), "mosi": _hex_out(bytes(x.mosi)),
                           "miso": _hex_out(bytes(x.miso)), "sck_hz": x.sck_hz,
                           "bit_rate_hz": x.bit_rate_hz,
                           **({"partial_bits": x.partial_bits} if x.partial_bits else {}),
                           **({} if x.complete else {"cut": True})} for x in tr[:max_items]]}


def _logic_summary(t, wait_s: float, channels, max_edges: int, vcd_path, csv_path, names,
                   protocol: Optional[str] = None, max_items: int = 50) -> dict:
    global _last_logic
    st = _wait_capture(t.logic, wait_s)
    if st["state"] != "done":
        return _not_done(st)
    cap = _last_logic = t.logic.read()
    out = {"state": "done", "captured": True, "rate_hz": cap.rate_hz, "n": cap.n,
           "trigger_index": cap.trigger_index, "duration_s": cap.n / cap.rate_hz, "channels": {}}
    for dio in (channels if channels is not None else range(8)):
        out["channels"][f"DIO{dio}"] = _logic_channel(cap, dio, max_edges)
    if vcd_path:
        cap.to_vcd(_abspath(vcd_path), _signal_names(names))
        out["vcd"] = _abspath(vcd_path)
    if csv_path:
        cap.to_csv(_abspath(csv_path))
        out["csv"] = _abspath(csv_path)
    if protocol:
        out["decoded"] = _decode(cap, protocol, max_items)
    return out


LogicChannels = Annotated[Optional[List[int]], Field(description="DIOs to summarise; omit for all 8.")]
SignalNames = Optional[Dict[str, str]]


def _signal_names(names: SignalNames) -> List[str]:
    """{dio: name} -> 8 names, DIO0 first; DIOs not named keep 'DIOi'."""
    out = [f"DIO{i}" for i in range(8)]
    for k, v in (names or {}).items():
        dio = int(str(k).upper().removeprefix("DIO"), 0)
        if not 0 <= dio <= 7:
            raise ValueError(f"names: {k!r} is not a DIO (0..7)")
        out[dio] = v
    return out
MaxEdges = Annotated[int, Field(ge=0, le=1000, description="Edges listed per channel.")]
VcdPath = Annotated[Optional[str], Field(description="Also save a VCD (PulseView/GTKWave) here.")]
LogicCsv = Annotated[Optional[str], Field(description="Also save a CSV here.")]
VcdNames = Annotated[SignalNames, Field(description=(
    "Signal names for the VCD, by DIO: {'2': 'CS', '5': 'SCK'}; unnamed DIOs stay 'DIOi'."))]
Decode = Annotated[Optional[Literal["uart", "i2c", "spi"]], Field(description=(
    "Also decode the capture with the J1 pinout: uart = DIO0 (target TX) with the baud rate "
    "guessed, i2c = DIO6/7, spi = DIO2..5 mode 0. Use logic_decode for other settings."))]
MaxItems = Annotated[int, Field(ge=1, le=2000, description="Decoded transfers/characters returned.")]


LOGIC_ARM_MAX_MS = 60_000   # per arm; the protocol's timeout is a u16 of ms


@tool
def logic_capture(
    n: Annotated[int, Field(ge=1, le=131072, description="Samples (<= 122880 with the pattern trigger).")] = 4096,
    rate_hz: Annotated[float, Field(gt=0, le=150e6, description=(
        "Sample rate: 150 MHz / integer divider. Pattern trigger: <= 15 MHz."))] = 10e6,
    trigger: Literal["none", "rising", "falling", "pattern"] = "none",
    pin: Annotated[int, Field(ge=0, le=7, description="DIO pin for rising/falling triggers.")] = 0,
    mask: Annotated[int, Field(ge=0, le=255, description="Pattern trigger: pins compared (bit i = DIOi).")] = 0,
    value: Annotated[int, Field(ge=0, le=255, description="Pattern trigger: required levels.")] = 0,
    pre: Annotated[int, Field(ge=0, description="Pre-trigger samples (pattern trigger only).")] = 0,
    timeout_ms: Annotated[int, Field(ge=1, le=3_600_000, description=(
        "Give up if no trigger. The board waits up to 60 s per arm; with wait=true longer "
        "values re-arm every 60 s (a trigger in the few ms between arms is missed). "
        "wait=false: 60 s at most."))] = 5000,
    wait: Annotated[bool, Field(description=(
        "True: wait and return the capture. False: only arm and return at once, so other tools "
        "can make traffic (i2c_*, spi_*, dio_write, uart_send...) before logic_read."))] = True,
    channels: LogicChannels = None,
    max_edges: MaxEdges = 32,
    vcd_path: VcdPath = None,
    csv_path: LogicCsv = None,
    names: VcdNames = None,
    decode: Decode = None,
    max_items: MaxItems = 50,
) -> dict:
    """Capture DIO0..DIO7 with the 8-channel logic analyzer. Returns, per
    channel, initial/final level, edge count, duty (high_fraction), frequency
    estimate and the first edges with times relative to the trigger. Save a
    VCD to inspect it in PulseView. Example, I2C START: trigger='pattern',
    mask=0x80, value=0x00 (SDA low) with pre=1000. To watch this board's own
    traffic, arm with wait=false, run the traffic, then logic_read.
    Sample at >= 4x the bit/clock rate if it is going to be decoded.
    If the trigger never comes the result has captured=false."""
    protocol = decode
    if not wait and timeout_ms > LOGIC_ARM_MAX_MS:
        raise ValueError(f"timeout_ms > {LOGIC_ARM_MAX_MS} needs wait=true (the MCP server re-arms)")

    def arm(t, ms):
        return t.logic.arm(n=n, rate_hz=int(rate_hz), trigger=trigger, pin=pin, mask=mask,
                           value=value, pre=pre, timeout_ms=ms)

    def f(t):
        if not wait:
            return {"state": "armed", "rate_hz": arm(t, timeout_ms), "next": "call logic_read"}
        deadline = time.monotonic() + timeout_ms / 1000
        rearms = 0
        while True:
            left_ms = int((deadline - time.monotonic()) * 1000)
            if timeout_ms <= LOGIC_ARM_MAX_MS or left_ms <= LOGIC_ARM_MAX_MS:
                break
            arm(t, LOGIC_ARM_MAX_MS)
            st = _wait_capture(t.logic, LOGIC_ARM_MAX_MS / 1000 + 5)
            if st["state"] != "timeout":
                out = _logic_summary(t, 5, channels, max_edges, vcd_path, csv_path, names, protocol, max_items)
                out["rearms"] = rearms
                return out
            rearms += 1
        ms = max(1, min(LOGIC_ARM_MAX_MS, int((deadline - time.monotonic()) * 1000))) if rearms else timeout_ms
        arm(t, ms)
        out = _logic_summary(t, ms / 1000 + 5, channels, max_edges, vcd_path, csv_path, names,
                             protocol, max_items)
        if rearms:
            out["rearms"] = rearms
        return out
    return _run(f)


@tool
def logic_read(
    wait_s: Annotated[float, Field(ge=0, le=60, description="How long to wait for the capture to finish.")] = 5.0,
    channels: LogicChannels = None,
    max_edges: MaxEdges = 32,
    vcd_path: VcdPath = None,
    csv_path: LogicCsv = None,
    names: VcdNames = None,
    decode: Decode = None,
    max_items: MaxItems = 50,
) -> dict:
    """Result of a capture armed with logic_capture(wait=false)."""
    protocol = decode
    return _run(lambda t: _logic_summary(t, wait_s, channels, max_edges, vcd_path, csv_path, names,
                                         protocol, max_items))


Dio = Annotated[int, Field(ge=0, le=7)]
OptDio = Annotated[Optional[int], Field(ge=0, le=7)]


@tool
def logic_decode(
    protocol: Literal["uart", "i2c", "spi"],
    pin: Annotated[Optional[int], Field(ge=0, le=7, description="UART: DIO to decode (default DIO0 = target TX).")] = None,
    baud: Annotated[Optional[int], Field(gt=0, description="UART: bit rate; omit to guess it from the shortest pulses.")] = None,
    parity: Literal["none", "even", "odd"] = "none",
    stop_bits: Literal[1, 2] = 1,
    scl: Dio = 6,
    sda: Dio = 7,
    cs: Annotated[Optional[int], Field(ge=0, le=7, description="SPI: CS DIO (active low); null = no CS.")] = 2,
    sck: Dio = 5,
    mosi: OptDio = 4,
    miso: OptDio = 3,
    spi_mode: Literal[0, 1, 2, 3] = 0,
    lsb_first: bool = False,
    max_items: MaxItems = 100,
) -> dict:
    """Decode the last logic capture again as UART, I2C or SPI, on any pins
    and with any settings, without capturing again. Use it to try another
    baud rate or SPI mode, or to decode a bus wired to other DIOs. UART
    returns the text and parity/framing error counts; I2C, frames such as
    'S 68W+ 75+  S 68R+ 71- P' (+ = ACK, - = NAK); SPI, MOSI/MISO bytes per
    CS-low window."""
    if _last_logic is None:
        raise RuntimeError("no logic capture yet: run logic_capture first")
    return _decode(_last_logic, protocol, max_items, pin, baud, parity, stop_bits, scl, sda,
                   cs, sck, mosi, miso, spi_mode, lsb_first)


def _png(fig) -> Image:
    buf = io.BytesIO()
    fig.savefig(buf, format="png", dpi=100, bbox_inches="tight")
    import matplotlib.pyplot as plt
    plt.close(fig)
    return Image(data=buf.getvalue(), format="png")


def _pyplot():
    try:
        import matplotlib
    except ImportError:
        raise RuntimeError('matplotlib is missing: install the extra, pip install "tramuntana[mcp]"') from None
    matplotlib.use("Agg")
    import matplotlib.pyplot as plt
    return plt


def _window(n: int, rate: float, trig: int, t_from_us, t_to_us) -> Tuple[int, int]:
    a = 0 if t_from_us is None else int(trig + t_from_us * 1e-6 * rate)
    b = n if t_to_us is None else int(trig + t_to_us * 1e-6 * rate) + 1
    a, b = max(0, a), min(n, b)
    if b - a < 2:
        raise ValueError("the time window holds less than two samples")
    return a, b


TFrom = Annotated[Optional[float], Field(description="Window start, us from the trigger; omit = capture start.")]
TTo = Annotated[Optional[float], Field(description="Window end, us from the trigger; omit = capture end.")]


@tool
def scope_image(t_from_us: TFrom = None, t_to_us: TTo = None) -> Image:
    """PNG plot of the last scope capture (volts vs time from the trigger),
    optionally zoomed into a time window, to look at the shape of a
    waveform: ringing, glitches, slow edges, noise, brown-outs."""
    cap = _last_scope
    if cap is None:
        raise RuntimeError("no scope capture yet: run scope_capture first")
    plt = _pyplot()
    a, b = _window(cap.n, cap.rate_hz, cap.trigger_index, t_from_us, t_to_us)
    ts = [x * 1e6 for x in cap.times()[a:b]]
    fig, ax = plt.subplots(figsize=(10, 4))
    for ch in range(cap.channels):
        ax.plot(ts, cap.volts(ch)[a:b], lw=0.9, label=f"AIN{ch}")
    if a <= cap.trigger_index < b:
        ax.axvline(0, color="grey", ls="--", lw=0.8)
    ax.set_xlabel("us from trigger")
    ax.set_ylabel("V")
    ax.grid(True, alpha=0.3)
    ax.legend(loc="upper right")
    ax.set_title(f"scope {cap.rate_hz / 1e3:g} kS/s, {b - a} samples")
    return _png(fig)


@tool
def logic_image(
    t_from_us: TFrom = None,
    t_to_us: TTo = None,
    channels: LogicChannels = None,
    names: Annotated[SignalNames, Field(description=(
        "Labels by DIO, as in logic_capture: {'2': 'CS', '5': 'SCK'}; unnamed DIOs show as 'DIOi'."))] = None,
) -> Image:
    """PNG timing diagram of the last logic capture, optionally zoomed into
    a time window (keep it to a few thousand samples so edges stay visible)
    and limited to some DIOs. Use the edge times from logic_capture or the
    t_us of decoded transfers to pick the window."""
    cap = _last_logic
    if cap is None:
        raise RuntimeError("no logic capture yet: run logic_capture first")
    plt = _pyplot()
    chans = list(channels) if channels is not None else list(range(8))
    all_names = _signal_names(names)
    labels = [all_names[d] for d in chans]
    a, b = _window(cap.n, cap.rate_hz, cap.trigger_index, t_from_us, t_to_us)
    ts = [(i - cap.trigger_index) * 1e6 / cap.rate_hz for i in range(a, b)]
    fig, axes = plt.subplots(len(chans), 1, sharex=True, figsize=(10, 0.6 * len(chans) + 1),
                             squeeze=False)
    for ax, d, lab in zip(axes[:, 0], chans, labels):
        ax.step(ts, [(s >> d) & 1 for s in cap.samples[a:b]], where="post", lw=0.9)
        ax.set_ylim(-0.2, 1.2)
        ax.set_yticks([])
        ax.set_ylabel(lab, rotation=0, ha="right", va="center")
        if a <= cap.trigger_index < b:
            ax.axvline(0, color="grey", ls="--", lw=0.8)
    axes[-1, 0].set_xlabel("us from trigger")
    fig.suptitle(f"logic {cap.rate_hz / 1e6:g} MS/s, {b - a} samples")
    return _png(fig)


# --- UART bridge -------------------------------------------------------------------

def _uart_close():
    global _tap
    if _tap is not None:
        _tap.close()
    _tap = None


def _need_tap() -> UartTap:
    if _tap is None:
        raise RuntimeError("UART bridge not open: call uart_open first")
    return _tap


def _uart_out(data: bytes) -> dict:
    return {"text": data.decode("utf-8", "replace"), "hex": _hex_out(data[:256]), "bytes": len(data)}


@tool
def uart_open(
    baud: Annotated[int, Field(gt=0, le=4_000_000)] = 115200,
    parity: Literal["none", "even", "odd"] = "none",
    stop_bits: Literal[1, 2] = 1,
    dtr: Annotated[Optional[bool], Field(description=(
        "Initial DTR; omit for the OS default (asserted). Matters with uart_ctrl."))] = None,
    rts: Annotated[Optional[bool], Field(description=(
        "Initial RTS; omit for the OS default (asserted). Matters with uart_ctrl."))] = None,
) -> dict:
    """Open the USB-UART bridge to the target's UART (DIO1 = TX to target,
    DIO0 = RX from target). The bridge follows this baud rate and framing.
    From then on everything the target sends is buffered in the background
    (uart_read collects it) and recorded on the timeline if one is running.
    While it is open DIO0/DIO1 belong to the UART (GPIO use gets 'busy');
    SPI and I2C keep working alongside."""
    global _tap
    with _lock:
        _uart_close()
        boards = [b for b in find_ports() if b["uart"] and (not _want_serial or b["serial"] == _want_serial)]
        if _dev is not None:
            boards = [b for b in boards if b["api"] == _dev.port] or boards
        if not boards:
            raise RuntimeError("no Tramuntana UART bridge port found")
        _tap = UartTap(None, baud, parity[0].upper(), stop_bits, dtr=dtr, rts=rts,
                       timeline=_timeline if _timeline is not None and _timeline.running else None,
                       port=boards[0]["uart"])
        return {"port": boards[0]["uart"], "baud": baud, "parity": parity, "stop_bits": stop_bits}


@tool
def uart_send(
    data: Annotated[str, Field(description="Text to send (or hex bytes if as_hex).")],
    as_hex: bool = False,
    newline: Annotated[Literal["none", "\n", "\r", "\r\n"], Field(description="Appended to text.")] = "\r\n",
    wait_s: Annotated[float, Field(ge=0, le=30, description="Then collect the target's reply for this long.")] = 0.5,
    until: Annotated[Optional[str], Field(description="Stop waiting once this text arrives (e.g. the prompt).")] = None,
) -> dict:
    """Send to the target's UART and return what it answers within wait_s
    (anything already buffered is returned too)."""
    tap = _need_tap()
    payload = _hex_in(data) if as_hex else (data + ("" if newline == "none" else newline)).encode()
    tap.write(payload)
    return _uart_out(tap.read(wait_s, until.encode() if until else None))


@tool
def uart_read(
    timeout_s: Annotated[float, Field(ge=0, le=60)] = 1.0,
    until: Annotated[Optional[str], Field(description="Stop early once this text arrives (e.g. a prompt).")] = None,
    max_bytes: Annotated[int, Field(ge=1, le=1_048_576)] = 65536,
) -> dict:
    """Read what the target sent on its UART since the last read (it is
    buffered in the background while the port is open): text, plus hex of
    the first 256 bytes."""
    return _uart_out(_need_tap().read(timeout_s, until.encode() if until else None, max_bytes))


@tool
def uart_close() -> str:
    """Close the UART bridge port (DIO0/DIO1 are released)."""
    with _lock:
        _uart_close()
    return "uart closed"


@tool
def uart_status() -> dict:
    """Bridge state: active, baud rate, byte counters and control lines."""
    return _run(lambda t: {**t.uart.status(), "open_here": _tap is not None,
                           "buffered": _tap.pending() if _tap else 0})


@tool
def uart_ctrl(
    mode: Annotated[Literal["esp", "direct", "off"], Field(description=(
        "esp: ESP32/ESP8266 auto-reset logic (reset low only with RTS and not DTR, boot low only "
        "with DTR and not RTS; both asserted - as when a port opens - does nothing). "
        "direct: reset = RTS, boot = DTR, like an adapter wired straight to the pins (opening the "
        "port holds the target in reset). off: release the pins."))] = "esp",
    reset_dio: Annotated[Optional[int], Field(ge=2, le=7, description="DIO wired to the target's reset/EN.")] = None,
    boot_dio: Annotated[Optional[int], Field(ge=2, le=7, description="DIO wired to the boot-mode pin (GPIO0, BOOT0...).")] = None,
) -> dict:
    """Map the UART bridge port's RTS/DTR to two DIOs as open-drain outputs
    (asserted = pulled low), the way a USB-serial adapter's control lines
    reset a target and select its bootloader. Then esptool (ESP32/ESP8266,
    'esp' mode) can flash the target through the bridge port (the 'uart'
    port of list_boards) unchanged, and uart_set_lines / uart_open(dtr,
    rts) drive the pins from here. The pins can only be pulled low: a
    boot pin that must go high (STM32 BOOT0) needs another way. The bridge stays active while this is
    on. Confirm the wiring with the user first: these pins are driven."""
    def f(t):
        t.uart.ctrl(mode, reset_dio, boot_dio)
        return t.uart.status()
    return _run(f)


@tool
def uart_set_lines(
    dtr: Optional[bool] = None,
    rts: Optional[bool] = None,
    pulse_ms: Annotated[Optional[int], Field(ge=1, le=10000, description=(
        "Set the lines, wait this long, then restore their previous state (a reset pulse)."))] = None,
) -> dict:
    """Set the bridge port's DTR/RTS (open the port with uart_open first).
    With uart_ctrl they drive the target's reset/boot pins: e.g. in 'esp'
    mode rts=True, dtr=False holds the target in reset."""
    tap = _need_tap()
    before = (tap.ser.dtr, tap.ser.rts)
    tap.set_lines(dtr, rts)
    if pulse_ms:
        time.sleep(pulse_ms / 1000)
        tap.set_lines(*before)
    return {"dtr": tap.ser.dtr, "rts": tap.ser.rts}


# --- timeline ------------------------------------------------------------------------

@tool
def timeline_start(
    watch_dios: Annotated[Optional[List[int]], Field(description=(
        "DIOs whose edges to record (reset, IRQ, enable, LED lines...). Not bus clocks: a pin "
        "toggling faster than ~50 edges/ms is muted for 100 ms."))] = None,
    dio_names: Annotated[Optional[Dict[str, str]], Field(description=(
        "Names for the watched DIOs, e.g. {'3': 'RESET', '0': 'TX'}."))] = None,
    clear: Annotated[bool, Field(description="Start empty (false keeps the previous entries).")] = True,
) -> dict:
    """Start recording a timeline: the target's UART output (once uart_open),
    sniffer messages (once sniff_start), edges on watch_dios, emulated-device
    transfers, sequencer runs, UART control-line changes, and every acting
    tool call made here - all on one clock, in seconds from now. Read it with
    timeline_read. Typical: timeline_start(watch_dios=[3]) -> uart_open ->
    sniff_start('i2c') -> power(on) -> timeline_read()."""
    global _timeline
    names = {int(k): v for k, v in (dio_names or {}).items()}
    mask = sum(1 << d for d in (watch_dios or []))

    def f(t):
        global _timeline
        if _timeline is None or _timeline.t is not t:
            _timeline = Timeline(t, dio_names=names)
        else:
            _timeline.dio_names.update(names)
        _timeline.start(watch=mask, clear=clear)
        if _tap is not None:
            _tap.timeline = _timeline
        return {"recording": True, "watching": [f"DIO{d}" for d in range(8) if mask >> d & 1],
                "uart": _tap is not None, "note": "sniffers are recorded once sniff_start is called"}
    return _run(f)


@tool
def timeline_read(
    since_s: Annotated[Optional[float], Field(description="From this time (s since timeline_start).")] = None,
    until_s: Annotated[Optional[float], Field(description="Up to this time.")] = None,
    sources: Annotated[Optional[List[Literal["uart", "uart_tx", "i2c", "spi", "dio", "emu", "line", "seq",
                                             "capture", "host", "mark"]]],
                       Field(description="Only these sources; omit for all.")] = None,
    contains: Annotated[Optional[str], Field(description="Only entries containing this text.")] = None,
    last: Annotated[int, Field(ge=1, le=2000, description="At most this many (the latest).")] = 200,
) -> dict:
    """The recorded timeline, one line per entry: 'seconds  source  text'.
    Sources: uart (target output), uart_tx (sent to it), i2c/spi (sniffed),
    dio (edges), emu (target <-> emulated device), line (DTR/RTS), seq
    (sequencer runs), capture, host (tool calls made here), mark. Board-
    stamped entries are exact to the microsecond; uart and host entries are
    stamped on arrival (~1 ms). Narrow it with since_s/until_s around an
    event instead of reading everything."""
    if _timeline is None:
        raise RuntimeError("no timeline: call timeline_start first")
    entries = _timeline.select(since_s, until_s, sources, contains)
    total = len(entries)
    entries = entries[-last:]
    return {"recording": _timeline.running, "now_s": round(_timeline._now(), 6), "matching": total,
            "shown": len(entries), "entries": [str(e) for e in entries]}


@tool
def timeline_mark(label: Annotated[str, Field(max_length=200)]) -> str:
    """Put a labelled marker on the timeline (e.g. before asking the user to
    press a button), to find that moment later."""
    if _timeline is None or not _timeline.running:
        raise RuntimeError("no timeline recording: call timeline_start first")
    _timeline.mark(label)
    return f"marked at {_timeline._now():.6f} s"


@tool
def timeline_stop() -> dict:
    """Stop recording (and the DIO watch). The entries stay readable."""
    if _timeline is None:
        return {"recording": False}
    with _lock:
        _timeline.stop()
    return {"recording": False, "entries": len(_timeline.entries)}


# --- emulated targets ----------------------------------------------------------------

Registers = Annotated[Optional[Dict[str, str]], Field(description=(
    "Registers to load first: {start register (hex or decimal): hex bytes}, e.g. "
    "{'0xD0': '60', '0x00': '00 11 22'}."))]
ReadOnly = Annotated[Optional[List[int]], Field(description="Registers whose writes are ignored (e.g. ID).")]


def _load_regs(t, registers, read_only):
    for k, v in (registers or {}).items():
        t.emu.set_regs(int(k, 0), _hex_in(v))
    if read_only is not None:
        t.emu.read_only(read_only)


@tool
def emu_i2c(
    address: Annotated[int, Field(ge=0x03, le=0x77, description="7-bit address to answer at.")],
    registers: Registers = None,
    read_only: ReadOnly = None,
    scl_dio: Annotated[int, Field(ge=0, le=7)] = 6,
    sda_dio: Annotated[int, Field(ge=0, le=7)] = 7,
    pullups: Annotated[bool, Field(description="Board pull-ups on (DIO6/DIO7 only).")] = False,
) -> dict:
    """Make the board answer as an I2C device on the target's bus (wire it
    like the real device: target SCL/SDA to scl_dio/sda_dio, default
    DIO6/DIO7). Register model: the first byte the target writes sets the
    register pointer, then data bytes are stored with auto-increment; reads
    return regs[ptr++]. Every transfer is recorded (emu_status, timeline).
    The board stretches SCL briefly after each byte, so the target's master
    must support clock stretching. Use it to feed the firmware chosen
    values (out-of-range, edge cases), or to check what it writes."""
    def f(t):
        _load_regs(t, registers, read_only)
        t.emu.i2c(address, scl_dio, sda_dio, pullups)
        return t.emu.status()
    return _run(f)


@tool
def emu_spi(
    registers: Registers = None,
    read_only: ReadOnly = None,
    mode: Literal[0, 1, 2, 3] = 0,
    cs_dio: Annotated[int, Field(ge=0, le=7)] = 2,
    sck_dio: Annotated[int, Field(ge=0, le=7)] = 5,
    mosi_dio: Annotated[int, Field(ge=0, le=7, description="Where the target's MOSI arrives.")] = 4,
    miso_dio: Annotated[int, Field(ge=0, le=7, description="Where the board drives the target's MISO.")] = 3,
    addr_mask: Annotated[int, Field(ge=0, le=255)] = 0x7F,
    read_mask: Annotated[int, Field(ge=0, le=255)] = 0x80,
    read_value: Annotated[int, Field(ge=0, le=255)] = 0x80,
    status: Annotated[int, Field(ge=0, le=255, description="MISO byte during the command byte.")] = 0,
) -> dict:
    """Make the board answer as a SPI device (default pins = the J1 SPI pins,
    wired like the sniffer). Each CS-low window starts with a command byte:
    if cmd & read_mask == read_value it reads register (cmd & addr_mask)
    and MISO returns regs[reg], regs[reg+1]... (up to 32); otherwise the
    MOSI bytes after it are written from that register. Defaults fit most
    sensors (bit 7 = read). Keep SCK <= ~2 MHz (modes 0/2: errors start
    around 7 MHz, in the MSB of the bytes after the first). Between
    transactions CS must stay high a few us (the board rearms in < 2 us
    after a CS rise, rarely up to ~50 us); a window that starts earlier is
    counted in emu_status 'late' and flagged suspect."""
    def f(t):
        _load_regs(t, registers, read_only)
        t.emu.spi(mode, cs_dio, sck_dio, mosi_dio, miso_dio, addr_mask, read_mask, read_value, status)
        return t.emu.status()
    return _run(f)


@tool
def emu_set_registers(
    start: Annotated[int, Field(ge=0, le=255)],
    data: Annotated[str, Field(description="Hex bytes, loaded from 'start' on.")],
) -> str:
    """Change the emulated device's registers (works while it runs: e.g.
    make the sensor report a new value, then watch what the firmware does)."""
    return _run(lambda t: (t.emu.set_regs(start, _hex_in(data)), f"{len(_hex_in(data))} registers set")[1])


@tool
def emu_get_registers(
    start: Annotated[int, Field(ge=0, le=255)] = 0,
    n: Annotated[int, Field(ge=1, le=256)] = 16,
) -> dict:
    """Read the emulated device's registers back - e.g. the configuration the
    target's firmware wrote."""
    return _run(lambda t: {"start": start, "data": _hex_out(t.emu.regs(start, n))})


@tool
def emu_status(last: Annotated[int, Field(ge=0, le=200)] = 20) -> dict:
    """Emulator counters and its last transfers with the target. 'dropped'
    counts transfers the board could not report (too many per second for
    the USB link): 'recent' and the timeline miss those, but 'transfers' and
    the byte counters include them. 'late' (SPI) counts CS windows that
    began before the emulator was ready; their entries say 'suspect'. Read
    entries show what went out on the bus."""
    def f(t):
        st = t.emu.status()
        st["recent"] = [str(x)[4:] for x in list(_emu_log)[-last:]] if last else []
        return st
    return _run(f)


@tool
def emu_stop() -> str:
    """Stop emulating and release the pins (the registers are kept)."""
    return _run(lambda t: (t.emu.stop(), "emulator off")[1])


# --- sequencer -----------------------------------------------------------------------

STEP_DOC = """Steps, run in order on the board (each a dict with 'op'):
  {'op':'delay_us','us':500}  {'op':'delay_ms','ms':20}
  {'op':'power','on':true}  {'op':'pullups','on':true}
  {'op':'dio_dir','pin':3,'output':true} or {'op':'dio_dir','mask':8,'out_mask':8}
  {'op':'dio_write','pin':3,'level':0} or {'op':'dio_write','mask':8,'value':0}
  {'op':'dio_read'}
  {'op':'wait_dio','pin':0,'level':1,'timeout_us':100000} (or mask/value): records how long it waited
  {'op':'i2c_write','address':0x76,'data':'f4 27'}  {'op':'i2c_read','address':0x76,'n':2}
  {'op':'i2c_write_read','address':0x76,'write':'d0','n':1}
  {'op':'spi_txn','write':'9f','read_n':3}
  {'op':'uart_send','text':'help\\r\\n'} or {'op':'uart_send','hex':'55 aa'} (bridge must be active)
  {'op':'awg_dc','volts':1.2}  {'op':'adc_read','channel':0}
  {'op':'pwm','dio':6,'freq_hz':1000000,'duty':50,'invert':false} (freq_hz 0 = stop that DIO)
  {'op':'pwm_sync','mask':0} (firmware >= 1.3 for both)
  {'op':'mark','id':1}  {'op':'watch','mask':8}
  {'op':'loop','count':10,'steps':[...]} (one level)
  {'op':'logic_arm', n, rate_hz, trigger, pin, mask, value, pre, timeout_ms} then logic_read afterwards
  {'op':'scope_arm', n, channels, rate_hz, trigger, level, pre, timeout_ms} then scope_read afterwards
Add 'keep_going': true to a step to record its failure and continue."""


def _pin_args(st, mask_key, value_key):
    if "pin" in st:
        pin = int(st["pin"])
        level = st.get("level", st.get("output", 0))
        return 1 << pin, (1 << pin) if level else 0
    return int(st[mask_key]), int(st.get(value_key, 0))


def _build_sequence(steps: List[Dict]) -> Sequence:
    s = Sequence()

    def add(st, in_loop):
        op = st.get("op")
        kg = bool(st.get("keep_going", False))
        if op == "delay_us":
            s.delay_us(int(st["us"]))
        elif op == "delay_ms":
            s.delay_ms(float(st["ms"]))
        elif op == "power":
            s.power(bool(st["on"]))
        elif op == "pullups":
            s.pullups(bool(st["on"]))
        elif op == "dio_dir":
            s.dio_dir(*_pin_args(st, "mask", "out_mask"))
        elif op == "dio_write":
            s.dio_write(*_pin_args(st, "mask", "value"), keep_going=kg)
        elif op == "dio_read":
            s.dio_read()
        elif op == "wait_dio":
            m, v = _pin_args(st, "mask", "value")
            s.wait_dio(m, v, int(st.get("timeout_us", 1_000_000)), keep_going=kg)
        elif op == "i2c_write":
            s.i2c_write(int(st["address"]), _hex_in(st["data"]), keep_going=kg)
        elif op == "i2c_read":
            s.i2c_read(int(st["address"]), int(st["n"]), keep_going=kg)
        elif op == "i2c_write_read":
            s.i2c_write_read(int(st["address"]), _hex_in(st["write"]), int(st["n"]), keep_going=kg)
        elif op == "spi_txn":
            s.spi_txn(_hex_in(st.get("write", "")), int(st.get("read_n", 0)), keep_going=kg)
        elif op == "uart_send":
            data = _hex_in(st["hex"]) if "hex" in st else st["text"].encode().decode("unicode_escape").encode()
            s.uart_send(data, keep_going=kg)
        elif op == "awg_dc":
            s.awg_dc(float(st["volts"]))
        elif op == "adc_read":
            s.adc_read(int(st.get("channel", 0)))
        elif op == "pwm":
            s.pwm(int(st["dio"]), float(st.get("freq_hz", 0)), float(st.get("duty", 50.0)),
                  bool(st.get("invert", False)), keep_going=kg)
        elif op == "pwm_sync":
            s.pwm_sync(int(st.get("mask", 0)))
        elif op == "mark":
            s.mark(int(st.get("id", 0)))
        elif op == "watch":
            s.watch(int(st["mask"]))
        elif op == "loop":
            if in_loop:
                raise ValueError("loops don't nest")
            s.loop(int(st["count"]))
            for sub in st.get("steps", []):
                add(sub, True)
            s.end_loop()
        elif op == "logic_arm":
            s.logic_arm(int(st.get("n", 4096)), float(st.get("rate_hz", 10e6)), st.get("trigger", "none"),
                        int(st.get("pin", 0)), int(st.get("mask", 0)), int(st.get("value", 0)),
                        int(st.get("pre", 0)), int(st.get("timeout_ms", 5000)))
        elif op == "scope_arm":
            s.scope_arm(int(st.get("n", 1024)), int(st.get("channels", 1)), st.get("rate_hz"),
                        st.get("trigger", "none"), float(st.get("level", 1.65)), int(st.get("pre", 0)),
                        int(st.get("timeout_ms", 5000)))
        else:
            raise ValueError(f"unknown step op {op!r}")

    for st in steps:
        add(st, False)
    return s


@tool
def sequence_run(
    steps: Annotated[List[Dict], Field(description=STEP_DOC)],
    timeout_s: Annotated[float, Field(gt=0, le=600)] = 10.0,
) -> dict:
    """Run a list of steps on the board itself, with microsecond timing
    between them (a host round trip per tool call is milliseconds). Use it
    for reset/boot sequences, 'release reset then talk to the device
    within N ms', waiting for an IRQ line, pulse trains, or arming a
    capture right before stimulating the target. Returns every executed
    step with its time from the first one (us), result value (levels,
    waited us, volts, bytes read) and status; the run stops at the first
    failing step unless that step has keep_going. Entries also go to the
    timeline when one is recording."""
    s = _build_sequence(steps)

    def f(t):
        r = t.seq.run(s, timeout_s)
        time.sleep(0.05)   # let the run's events (emulator, sniffers, edges) reach the timeline
        out = {"state": r.state, "error": r.error, "steps": []}
        for st in r.steps:
            v = st.value
            if isinstance(v, (bytes, bytearray)):
                v = _hex_out(bytes(v))
            item = {"t_us": st.dt_us, "step": st.label or st.op, "ok": st.ok}
            if not st.ok:
                item["status"] = st.status
            if v is not None:
                item["value"] = v
            out["steps"].append(item)
        if r.state != "done":
            out["stopped_at"] = s.labels.get(r.pc, f"pc {r.pc}")
        return out
    return _run(f)


def main():
    """Entry point of the tramuntana-mcp script: serve over stdio."""
    mcp.run()


if __name__ == "__main__":
    main()
