controlpaths/tramuntana/host/python/tramuntana/timeline.py

"""
One timeline for everything the board sees: the target's UART output, the
I2C/SPI sniffers, edges on watched DIOs, transfers with an emulated
device, the host's control lines, sequencer runs - and the host's own
actions and marks - all on one clock, so cause and effect line up:

     0.000  host   power on
     0.012  dio    DIO3^                         (reset released)
     0.150  uart   Booting v1.2...
     0.153  i2c    S 76W- P                      (sensor not answering yet)
     0.154  uart   sensor not found

    from tramuntana import Tramuntana, Timeline

    with Tramuntana() as t:
        tl = Timeline(t)
        tl.start(watch=1 << 3)          # DIO3 edges too
        t.i2c.sniff(True)
        tap = tl.open_uart(115200)      # the target's console
        t.power(True)
        time.sleep(2)
        print(tl.format())

Times are seconds from ``start()``. Events stamped by the board keep its
microsecond clock, mapped onto the host's with a periodic CMD_TIME sync:
DIO edges, emulator transfers, control lines and sequencer runs exactly,
sniffer messages exactly too (the sniffer's PIO stamps the START / CS
edge). UART lines and host entries carry the host time at which they
arrived or happened: a millisecond or so late, plus the UART's receive
FIFO, which hands bytes over in groups (up to ~1.5 ms at 115200 baud,
proportionally more at lower rates).
"""
from __future__ import annotations
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
